AdvancingMind/Spyder-Crab/README.md

# Spyder-Crab
This is the spider crab design using Klann mechanism. We call it OCTBUT! :)

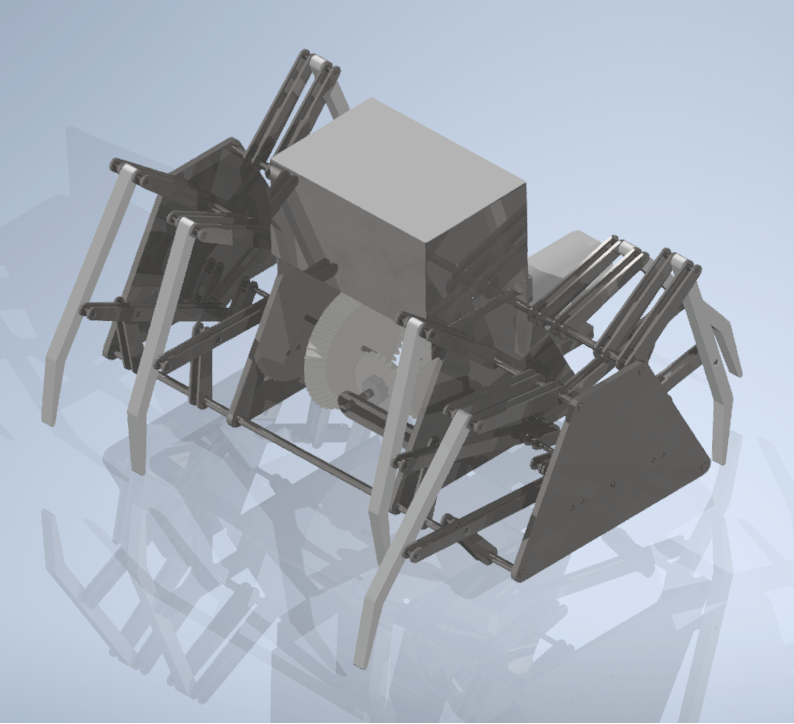
[picture p1: OCTBUG.png]

![]()
