AdvancingMind/Spyder-Crab/Drawings/Pdf/Untitled.png

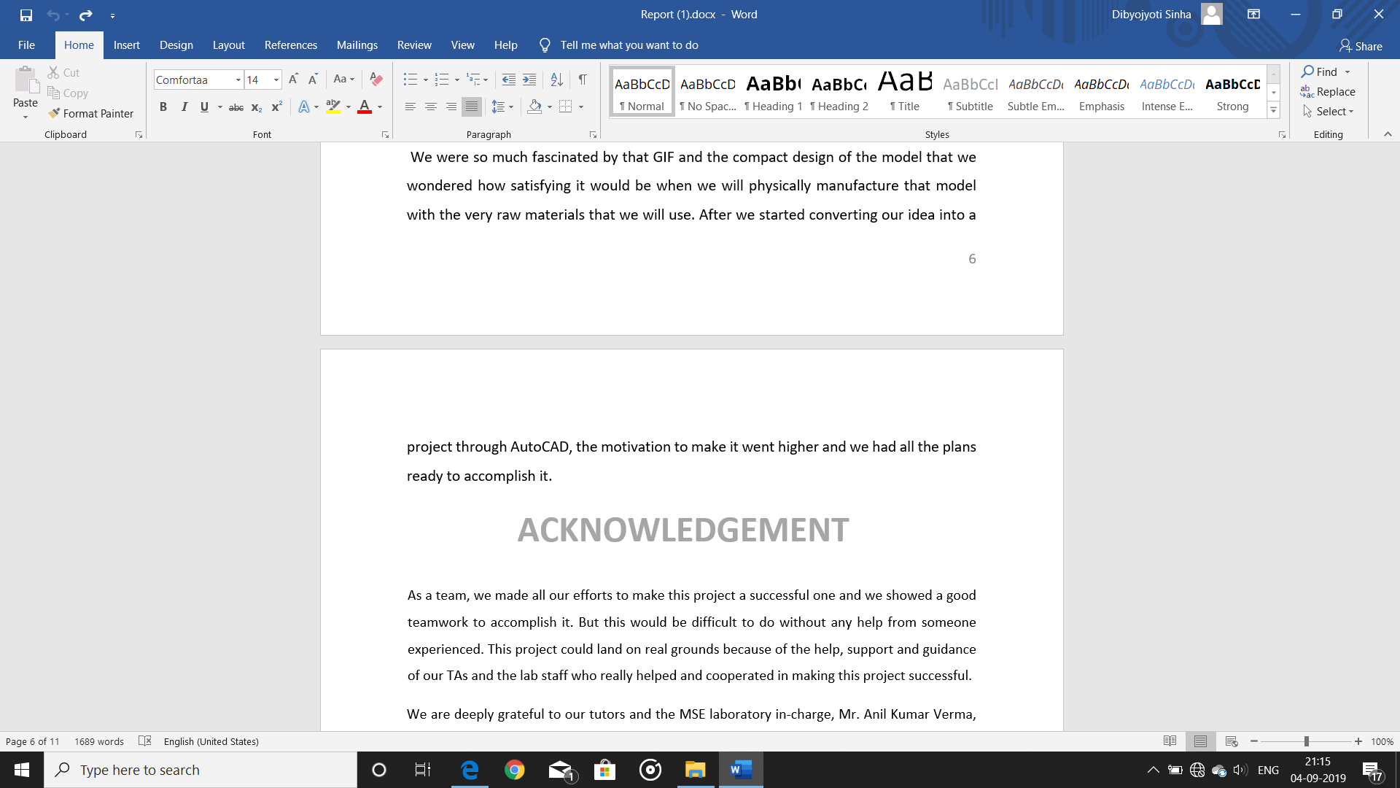
Drawings/Pdf/Untitled.png
