AdvancingMind/Spyder-Crab/sketch.dxf

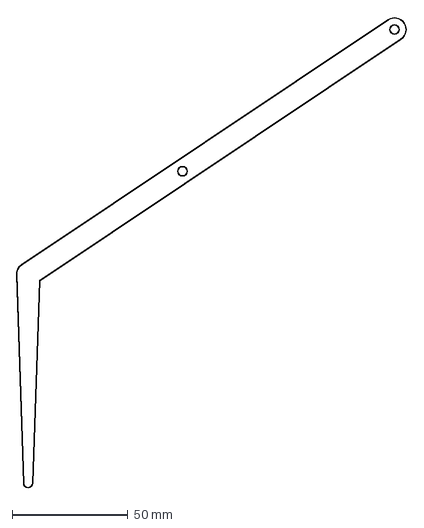
[picture p9: CAD file, 2020-01-12]
sketch.dxf
168.8 x 203.2 mm
