AdvancingMind/Spyder-Crab/(list of files, cad)

Other CAD files:
Drawings/Cabin Wall Assembly.dwg
Drawings/Main Assembly Spider Crab.dwg
Drawings/Leg Pair Assembly Spider Crab.dwg
Drawings/1-1 Templates/parts set 1.dwg
Drawings/Cabin Side Panel.dwg
Drawings/1-1 Templates/parts set 2.dwg
Drawings/Leg Spider Crab.dwg
Drawings/1-1 Templates/parts set 3.dwg
Drawings/Crank Joint Pin Spider Crab.dwg
Drawings/Upper Rocker Arm Spider Crab.dwg
Drawings/Cabin Frame.dwg
Drawings/Lower Rocker Arm Spider Crab.dwg
Drawings/Crank.dwg
Drawings/Rocker arm.dwg
Drawings/Frame.dwg
Drawings/Flywheel.dwg
Drawings/Cabin Hold.dwg
Drawings/Leg Joint Pins.dwg
Battery Box.ipt
Cabin Assembly.iam
Cabin Back Panel.ipt
Cabin Frame.ipt
Cabin Frame_MIR.ipt
Cabin Hold.ipt
Cabin Hold_MIR.ipt
Cabin Roof.ipt
Cabin Side Panel.ipt
Cabin Side Panel_MIR.ipt
Cabin Wall Assembly.iam
Cabin Wall Assembly_MIR.iam
Cabin front panel.ipt
Crank Joint Pin Spider Crab.ipt
Crank Joint Pin extended Spider Crab.ipt
Crank.ipt
Drawings/1-1 Templates/OldVersions/parts set 1.0002.dwg
Drawings/1-1 Templates/OldVersions/parts set 2.0004.dwg
Drawings/1-1 Templates/OldVersions/parts set 3.0002.dwg
Drawings/Dummy Parts/Crank Coupler Pin 40mm.ipt
Drawings/Dummy Parts/Crank Coupler Pin Extended 138 mm.ipt
Drawings/Dummy Parts/Flywheel with hole.ipt
Drawings/Dummy Parts/OldVersions/Crank Coupler Pin 40mm.0001.ipt
Drawings/Dummy Parts/OldVersions/Crank Coupler Pin Extended 138 mm.0001.ipt
Drawings/Dummy Parts/OldVersions/Flywheel with hole.0005.ipt
Drawings/OldVersions/Cabin Frame.0001.dwg
Drawings/OldVersions/Cabin Hold.0001.dwg
Drawings/OldVersions/Cabin Side Panel.0002.dwg
Drawings/OldVersions/Cabin Wall Assembly.0001.dwg
Drawings/OldVersions/Crank Joint Pin Spider Crab.0004.dwg
Drawings/OldVersions/Crank.0005.dwg
Drawings/OldVersions/Flywheel.0002.dwg
Drawings/OldVersions/Frame.0003.dwg
Drawings/OldVersions/Joint Pins.0003.dwg
Drawings/OldVersions/Leg Joint Pins.0005.dwg
Drawings/OldVersions/Leg Pair Assembly Spider Crab.0004.dwg
Drawings/OldVersions/Leg Spider Crab.0007.dwg
Drawings/OldVersions/Lower Rocker Arm Spider Crab.0008.dwg
Drawings/OldVersions/Main Assembly Spider Crab.0007.dwg
Drawings/OldVersions/Rocker arm.0006.dwg
Drawings/OldVersions/Upper Rocker Arm Spider Crab.0003.dwg
Flywheel.ipt
Frame.ipt
Joint Pin Spider Crab.ipt
Leg Pair Assembly Spider Crab.iam
Leg Spider Crab.ipt
Long Joint Pin Spider Crab.ipt
Lower Rocker Arm Spider Crab.ipt
Main Assembly Spider Crab.iam
OldVersions/6x6mm square rod.0001.ipt
OldVersions/Assembly Spider Crab.0006.iam
OldVersions/Battery Box.0006.ipt
OldVersions/Cabin Assembly.0029.iam
OldVersions/Cabin Back Panel.0002.ipt
OldVersions/Cabin Frame.0005.ipt
OldVersions/Cabin Frame_MIR.0002.ipt
OldVersions/Cabin Hold.0006.ipt
OldVersions/Cabin Hold_MIR.0001.ipt
OldVersions/Cabin Roof.0002.ipt
OldVersions/Cabin Side Panel.0006.ipt
OldVersions/Cabin Side Panel_MIR.0002.ipt
OldVersions/Cabin Side.0012.ipt
OldVersions/Cabin Wall Assembly.0009.iam
OldVersions/Cabin Wall Assembly_MIR.0002.iam
OldVersions/Cabin Wall.0015.ipt
OldVersions/Cabin Wall_MIR2.0002.ipt
OldVersions/Cabin front panel.0003.ipt
OldVersions/Cabin.0004.ipt
OldVersions/Crank Joint Pin Spider Crab.0003.ipt
OldVersions/Crank Joint Pin Spider Crab.0004.ipt
OldVersions/Crank Joint Pin Spider Crab.0005.ipt
OldVersions/Crank Joint Pin Spider Crab.0006.ipt
OldVersions/Crank Joint Pin extended Spider Crab.0004.ipt
OldVersions/Crank Joint Pin extended Spider Crab.0005.ipt
OldVersions/Crank.0007.ipt
OldVersions/Flywheel.0005.ipt
OldVersions/Frame.0003.ipt
OldVersions/Joint Pin Spider Crab.0002.ipt
OldVersions/Joint Pin Spider Crab.0003.ipt
OldVersions/Joint Pin Spider Crab.0004.ipt
OldVersions/Joint Pin Spider Crab.0005.ipt
OldVersions/Leg Pair Assembly Spider Crab.0035.iam
OldVersions/Leg Spider Crab.0006.ipt
OldVersions/Leg Spider Crab.0007.ipt
OldVersions/Long Joint Pin Spider Crab.0001.ipt
OldVersions/Lower Rocker Arm Spider Crab.0009.ipt
OldVersions/Lower Rocker Arm Spider Crab.0010.ipt
OldVersions/Main Assembly Spider Crab.0065.iam
OldVersions/Rocker arm Leg Spider Crab.0006.ipt
OldVersions/Rocker arm Leg Spider Crab.0007.ipt
OldVersions/Rocker arm Leg Spider Crab.0008.ipt
OldVersions/Short Joint Pin Spider Crab.0001.ipt
OldVersions/Short Joint Pin Spider Crab.0002.ipt
OldVersions/Upper Rocker Arm Spider Crab.0006.ipt
OldVersions/Upper Rocker Arm Spider Crab.0007.ipt
OldVersions/Upper Rocker Arm Spider Crab.0008.ipt
OldVersions/Upper Rocker Arm Spider Crab.0010.ipt
OldVersions/Upper Rocker Arm Spider Crab.0012.ipt
OldVersions/Upper Rod Spider Crab.0001.ipt
OldVersions/Upper Rod Spider Crab.0002.ipt
OldVersions/Upper Rod Spider Crab.0003.ipt
OldVersions/Upper Rod Spider Crab.0004.ipt
OldVersions/Upper Rod Spider Crab.0005.ipt
OldVersions/Upper Rod extended Spider Crab.0004.ipt
OldVersions/Upper Rod extended Spider Crab.0005.ipt
Part1.ipt
Rocker arm Leg Spider Crab.ipt
Short Joint Pin Spider Crab.ipt
Upper Rocker Arm Spider Crab.ipt
Upper Rod Spider Crab.ipt
Upper Rod extended Spider Crab.ipt
test Main Assembly Spider Crab.ipn
