AdvancingMind/Spyder-Crab/Drawings/Pdf/Main Assembly Spider Crab.bmp

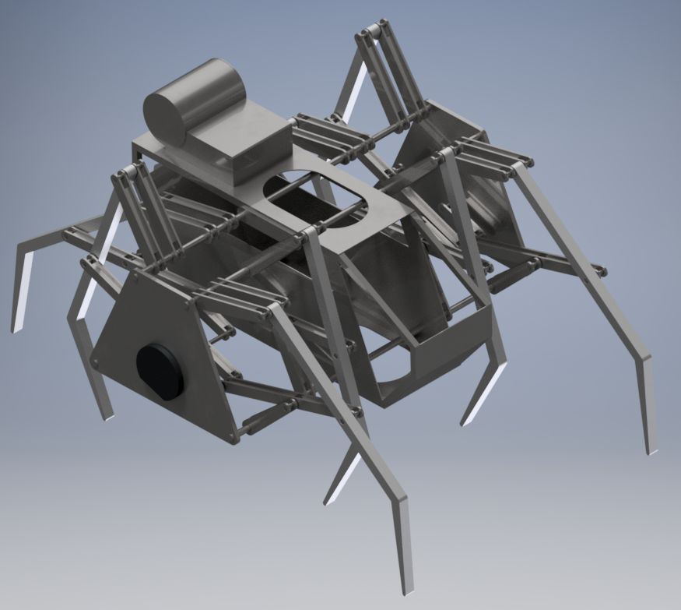
Drawings/Pdf/Main Assembly Spider Crab.bmp
