AdvancingMind/Spyder-Crab/Main Assembly Spider Crab.bmp

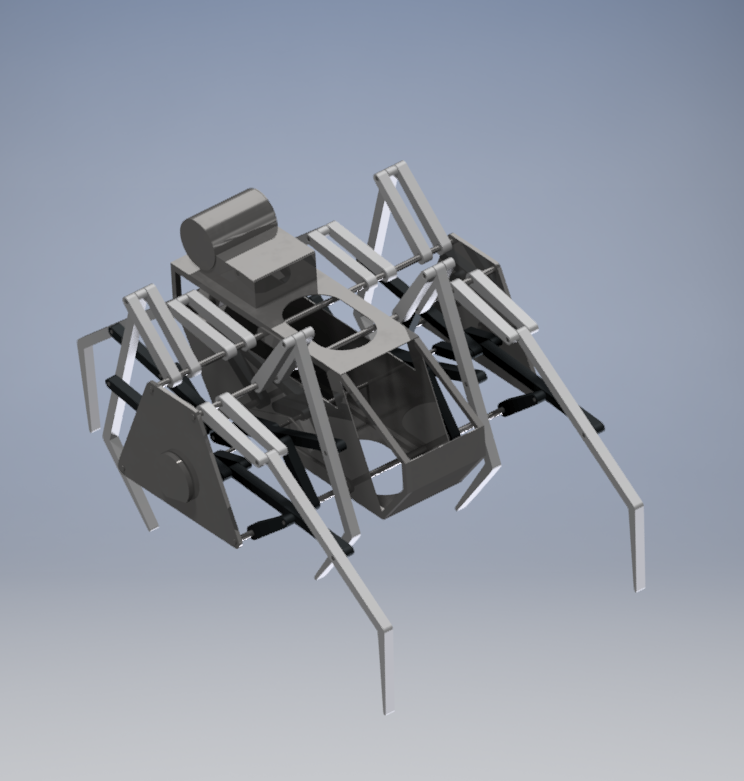
Main Assembly Spider Crab.bmp
