AdvancingMind/Spyder-Crab/Drawings/1-1 Templates/pdf/parts set 1.pdf

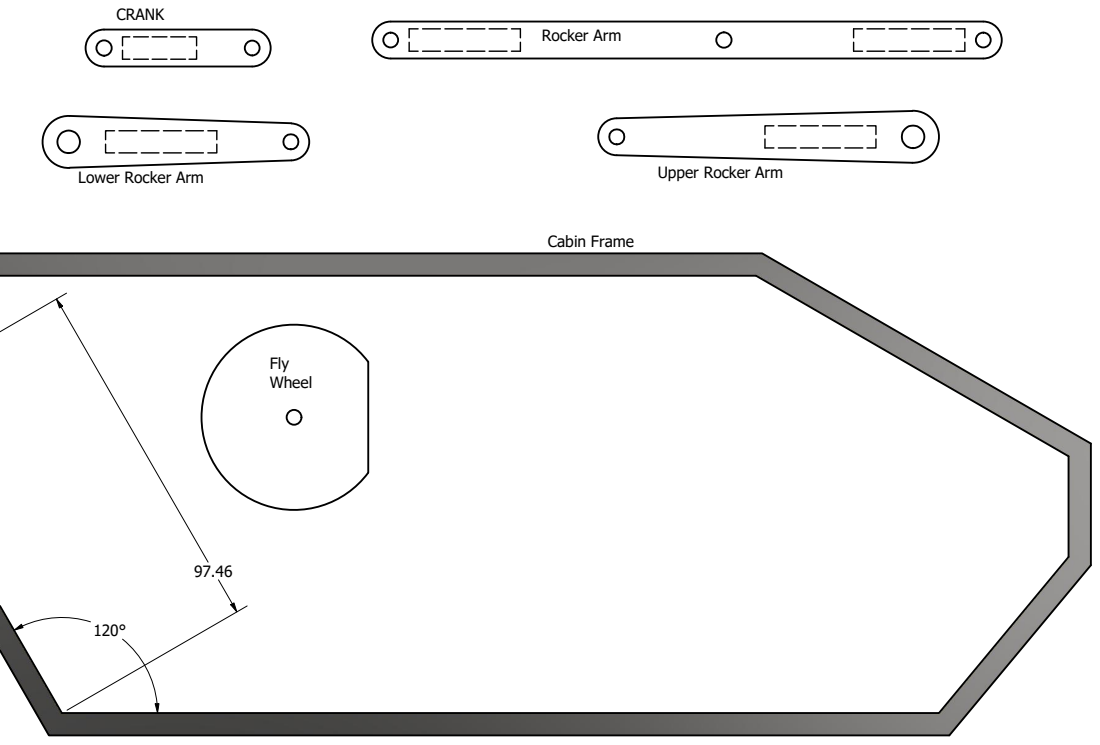
[picture p12: page 1]
Cabin Frame; Rocker Arm; Lower Rocker Arm; Upper Rocker Arm
