AdvancingMind/Spyder-Crab/Drawings/1-1 Templates/pdf/parts set 2.pdf

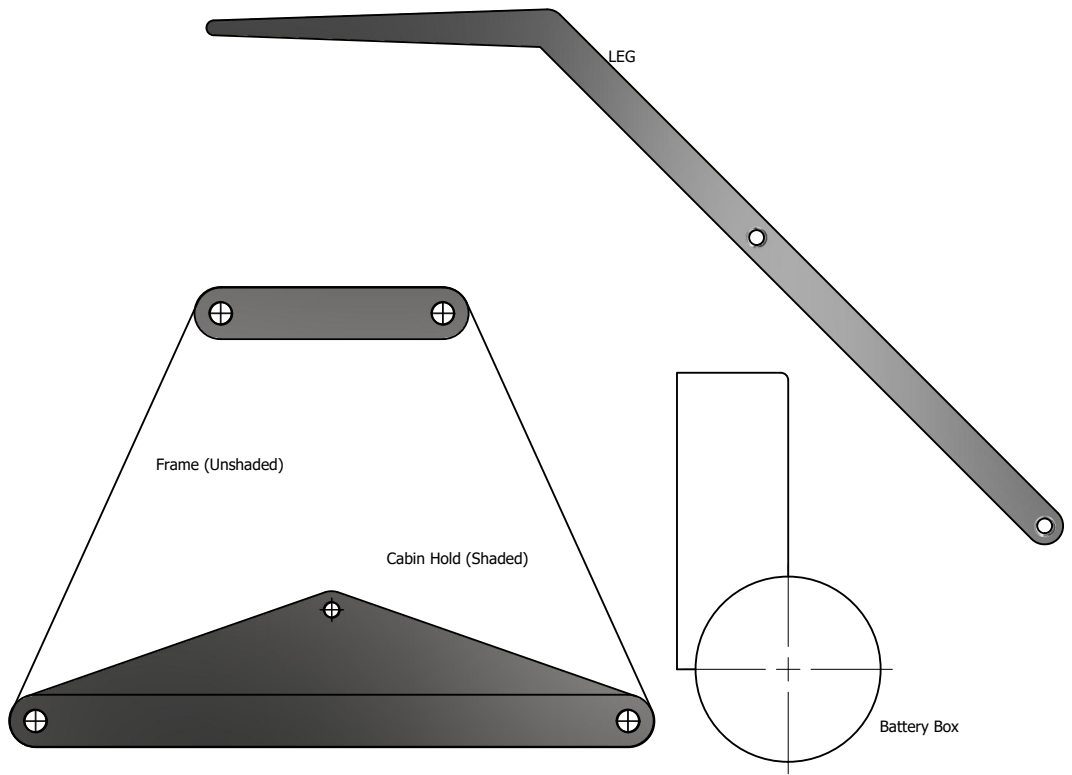
[picture p13: page 1]
Frame (Unshaded); Battery Box

Cabin Hold (Shaded)
