AdvancingMind/Spyder-Crab/Drawings/1-1 Templates/pdf/parts set 3.pdf

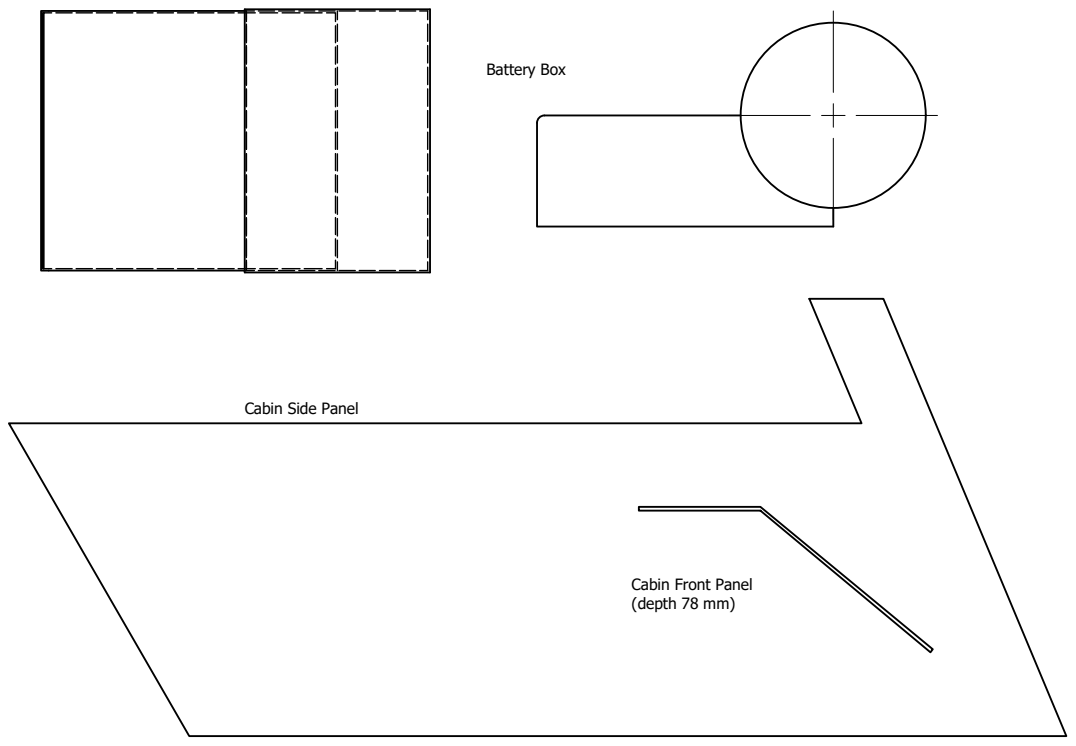
[picture p14: page 1]
Battery Box

Cabin Side Panel

Cabin Front Panel
(depth 78 mm)
