AdvancingMind/Spyder-Crab/Drawings/Pdf/Autocad Pdf/Cabin Assembly.pdf

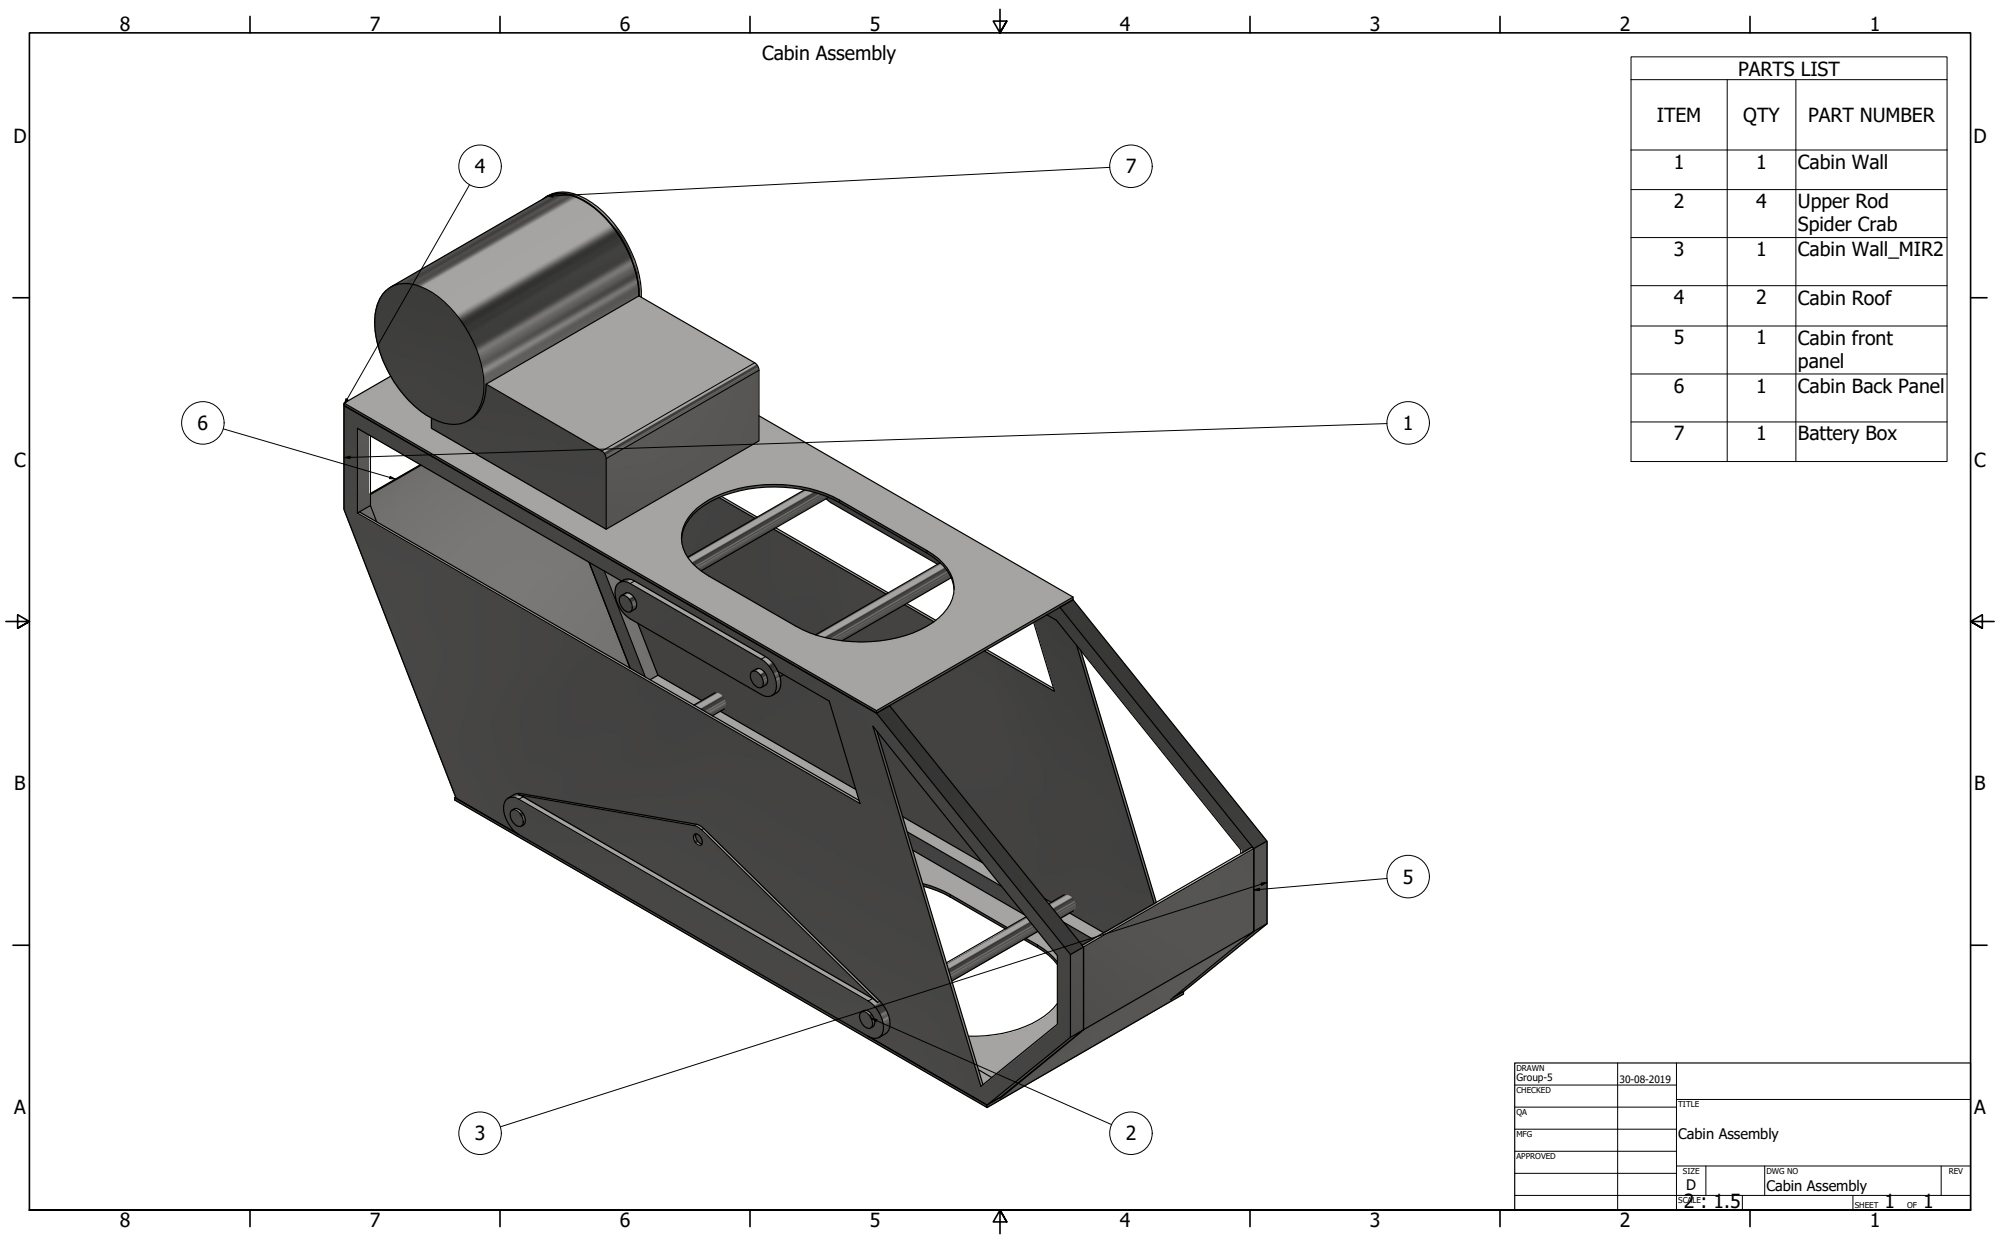
[picture p15: page 1]
Battery Box 11

1 | 1 | C a b i n W all Upper Rod Spider Cra

3 | 1 | C a b i n W all_ M I R 2

1 6 1 | C Cabin a b el 5 i n f r o n t p a n

S I Z E D | D W G N O C a b i n A s s e m bly | R E V
