AdvancingMind/Spyder-Crab/Drawings/Pdf/Autocad Pdf/Cabin Wall Assembly.pdf

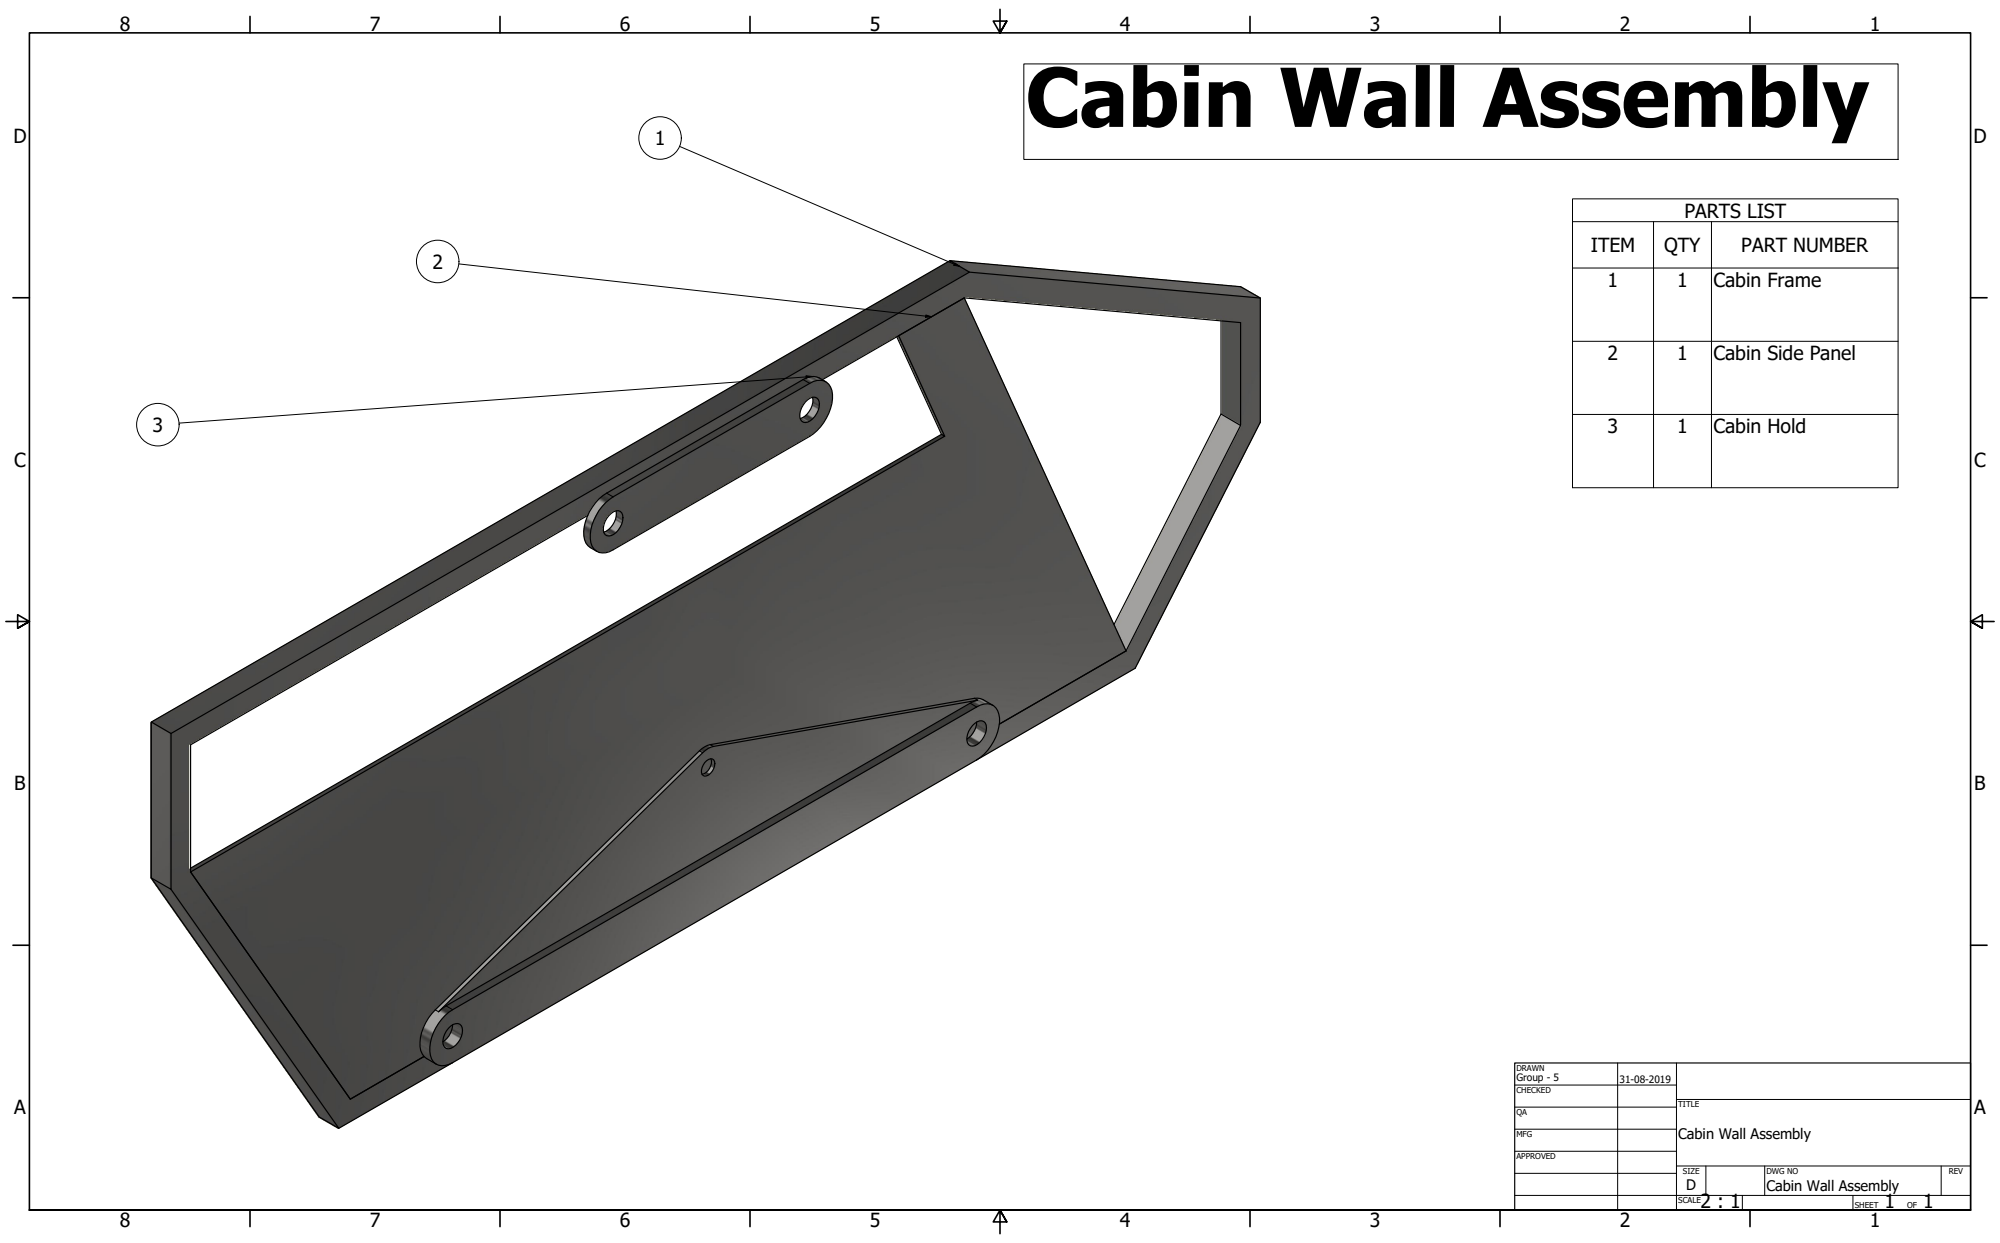
[picture p16: page 1]
PARTS LIST

Cabin Wall Assembly

ITEM | QTY | PART NUMBER
1 | 1 | Cabin Frame

2 | 1 | Cabin Side Panel

3 | 1 | Cabin Hold

DRAWN Group - 5 | 31-08-2019

CHECKED

MFG

APPROVED

SIZE D | DWG NO Cabin Wall Assembly | REV

2 : 1 SCALE | | SHEET 1 OF 1
