AdvancingMind/Spyder-Crab/Drawings/Pdf/Autocad Pdf/Main Assembly Spider Crab.pdf

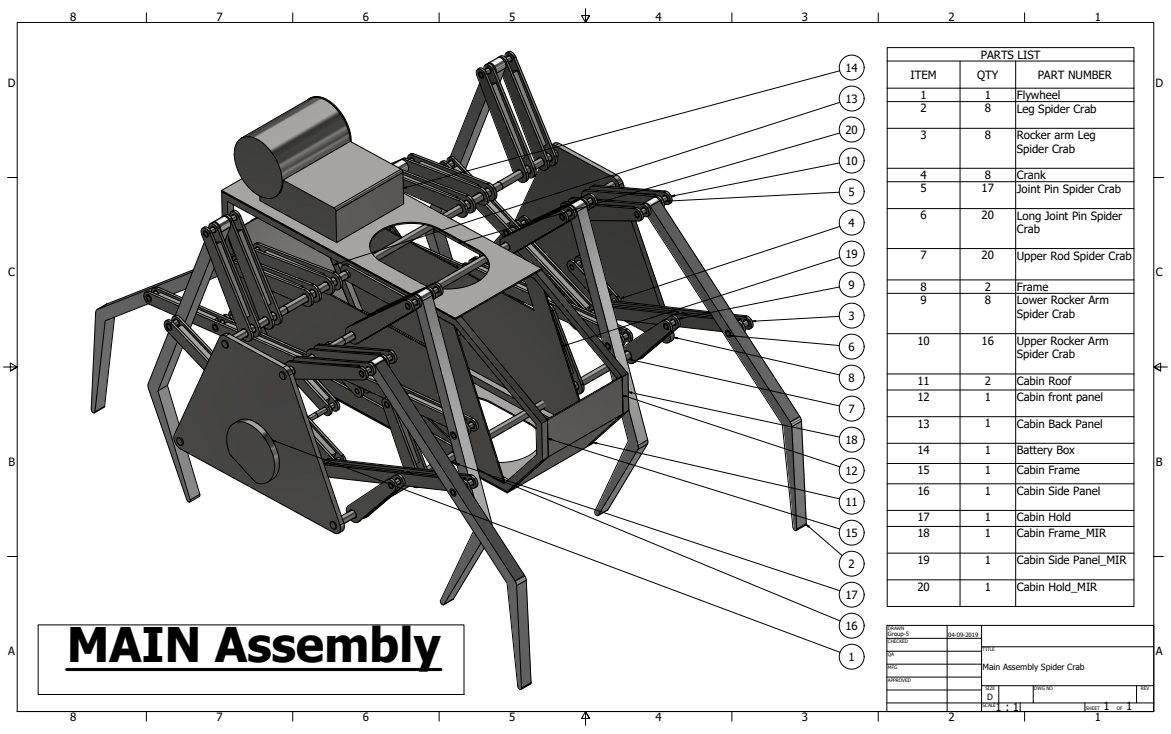
[picture p17: page 1]
Cabin Back Panel 14; Battery Box 15; Cabin Frame 16; Cabin Side Panel 17; Cabin Hold 18; Cabin Frame_MIR 19; Cabin Side Panel_

I T E M | Q TY | P A RT N U M B E R
1 | 1 8 | Fly Leg Spid w h e el 2

4 | 8 | C r a n k
5 | 1 7 | J o i n t P i n S p i d e r C r a b

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

1 1 | 2 | C a b i n R o o f
1 2 | 1 | C a b i n f r o n t p a n

2 0 | 1 | C a b i n H old _ M I
