AdvancingMind/Spyder-Crab/Drawings/Pdf/Autocad Pdf/Battery box.pdf

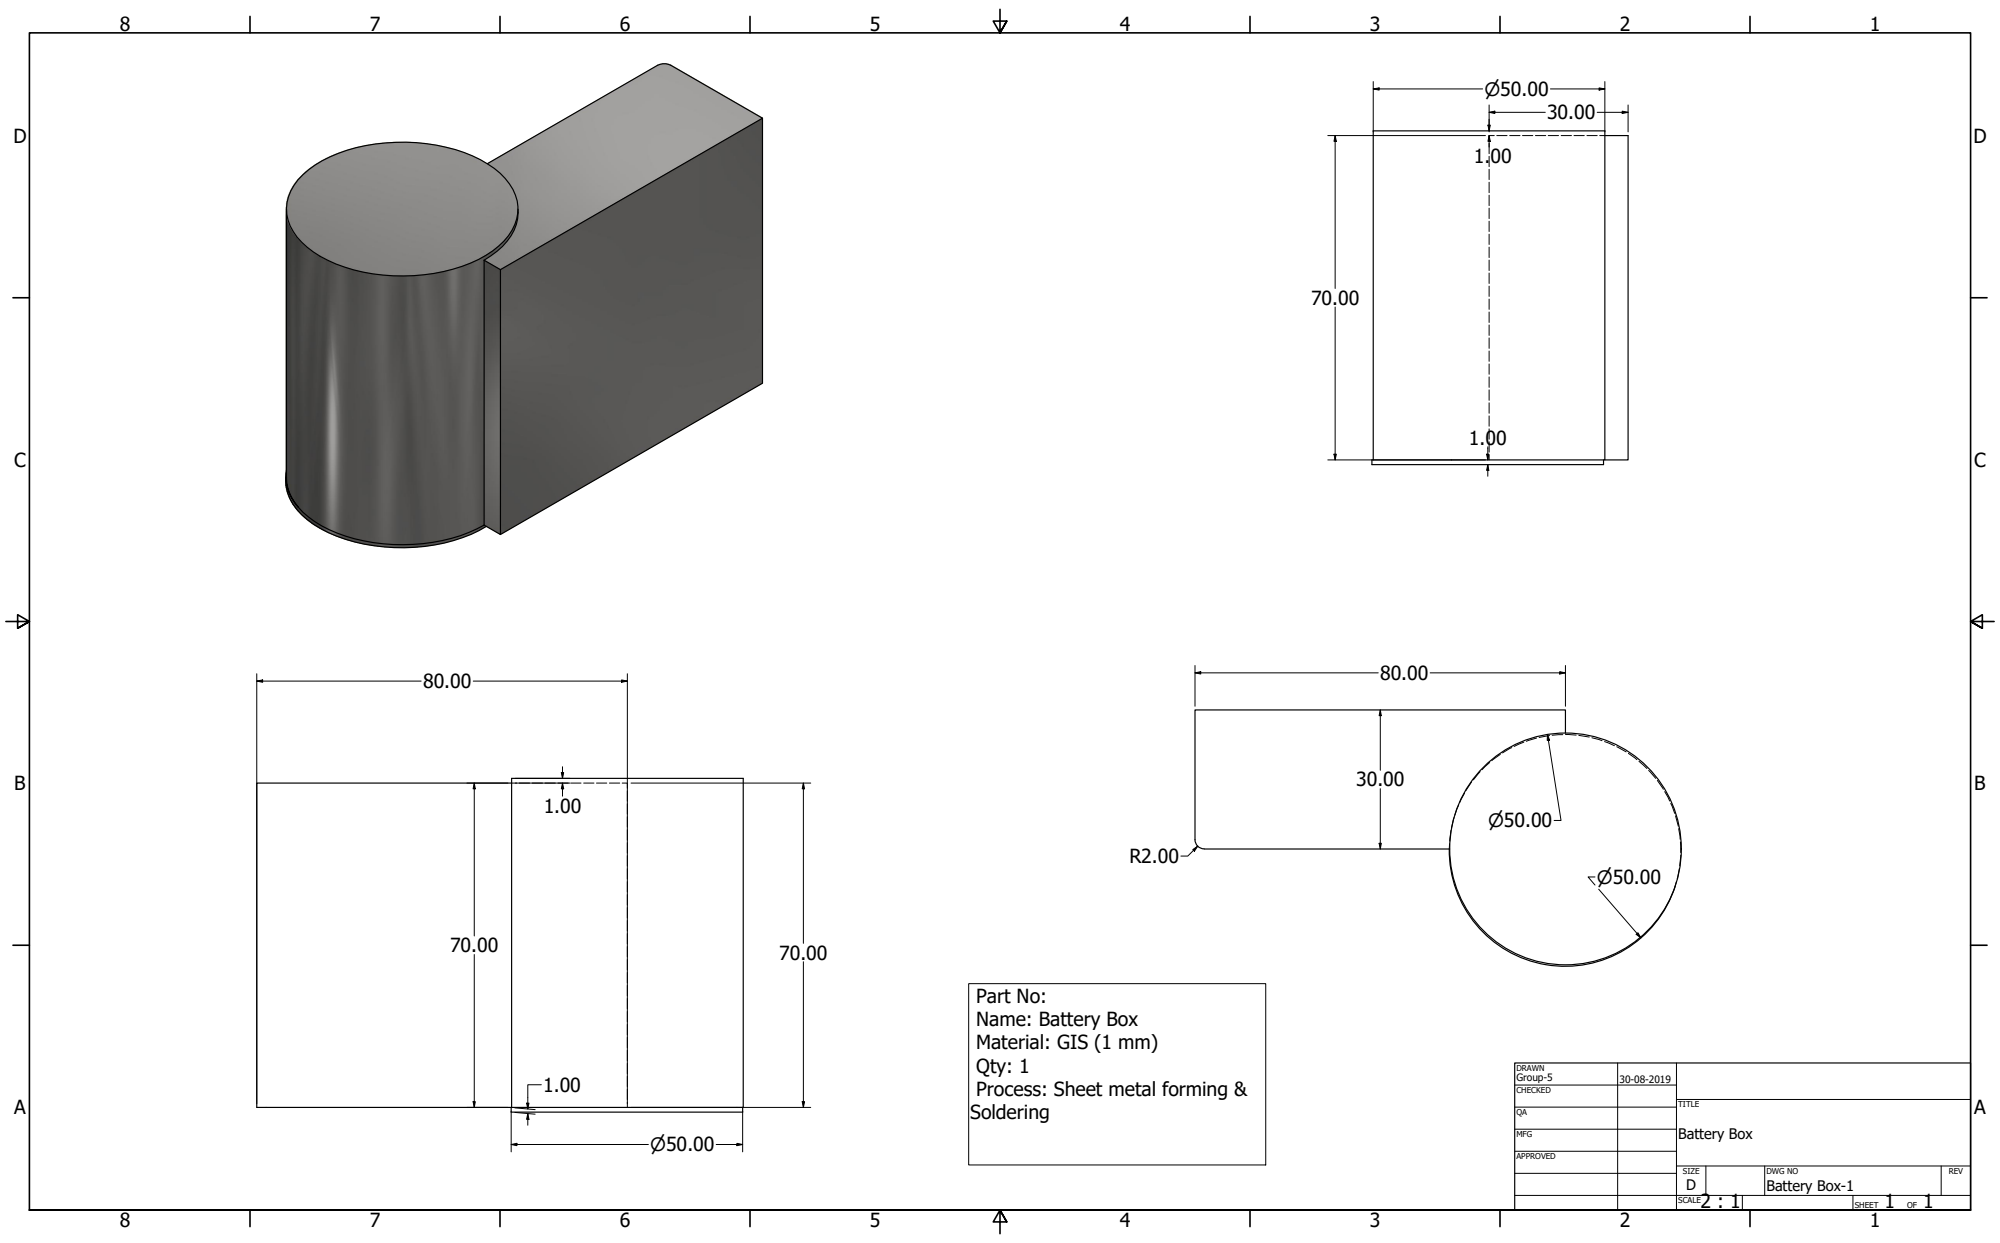
[picture p18: page 1]
Battery Box

Part No:
Name: Battery Box
Material: GIS (1 mm)
Qty: 1
Process: Sheet metal forming &
Soldering

DRAWN Group-5 | 30-08-2019

CHECKED

MFG

APPROVED

SIZE D | DWG NO Battery Box-1 | REV

2 : 1 SCALE | | SHEET 1 OF 1
