AdvancingMind/Spyder-Crab/Drawings/Pdf/Autocad Pdf/Cabin Back Panel.pdf

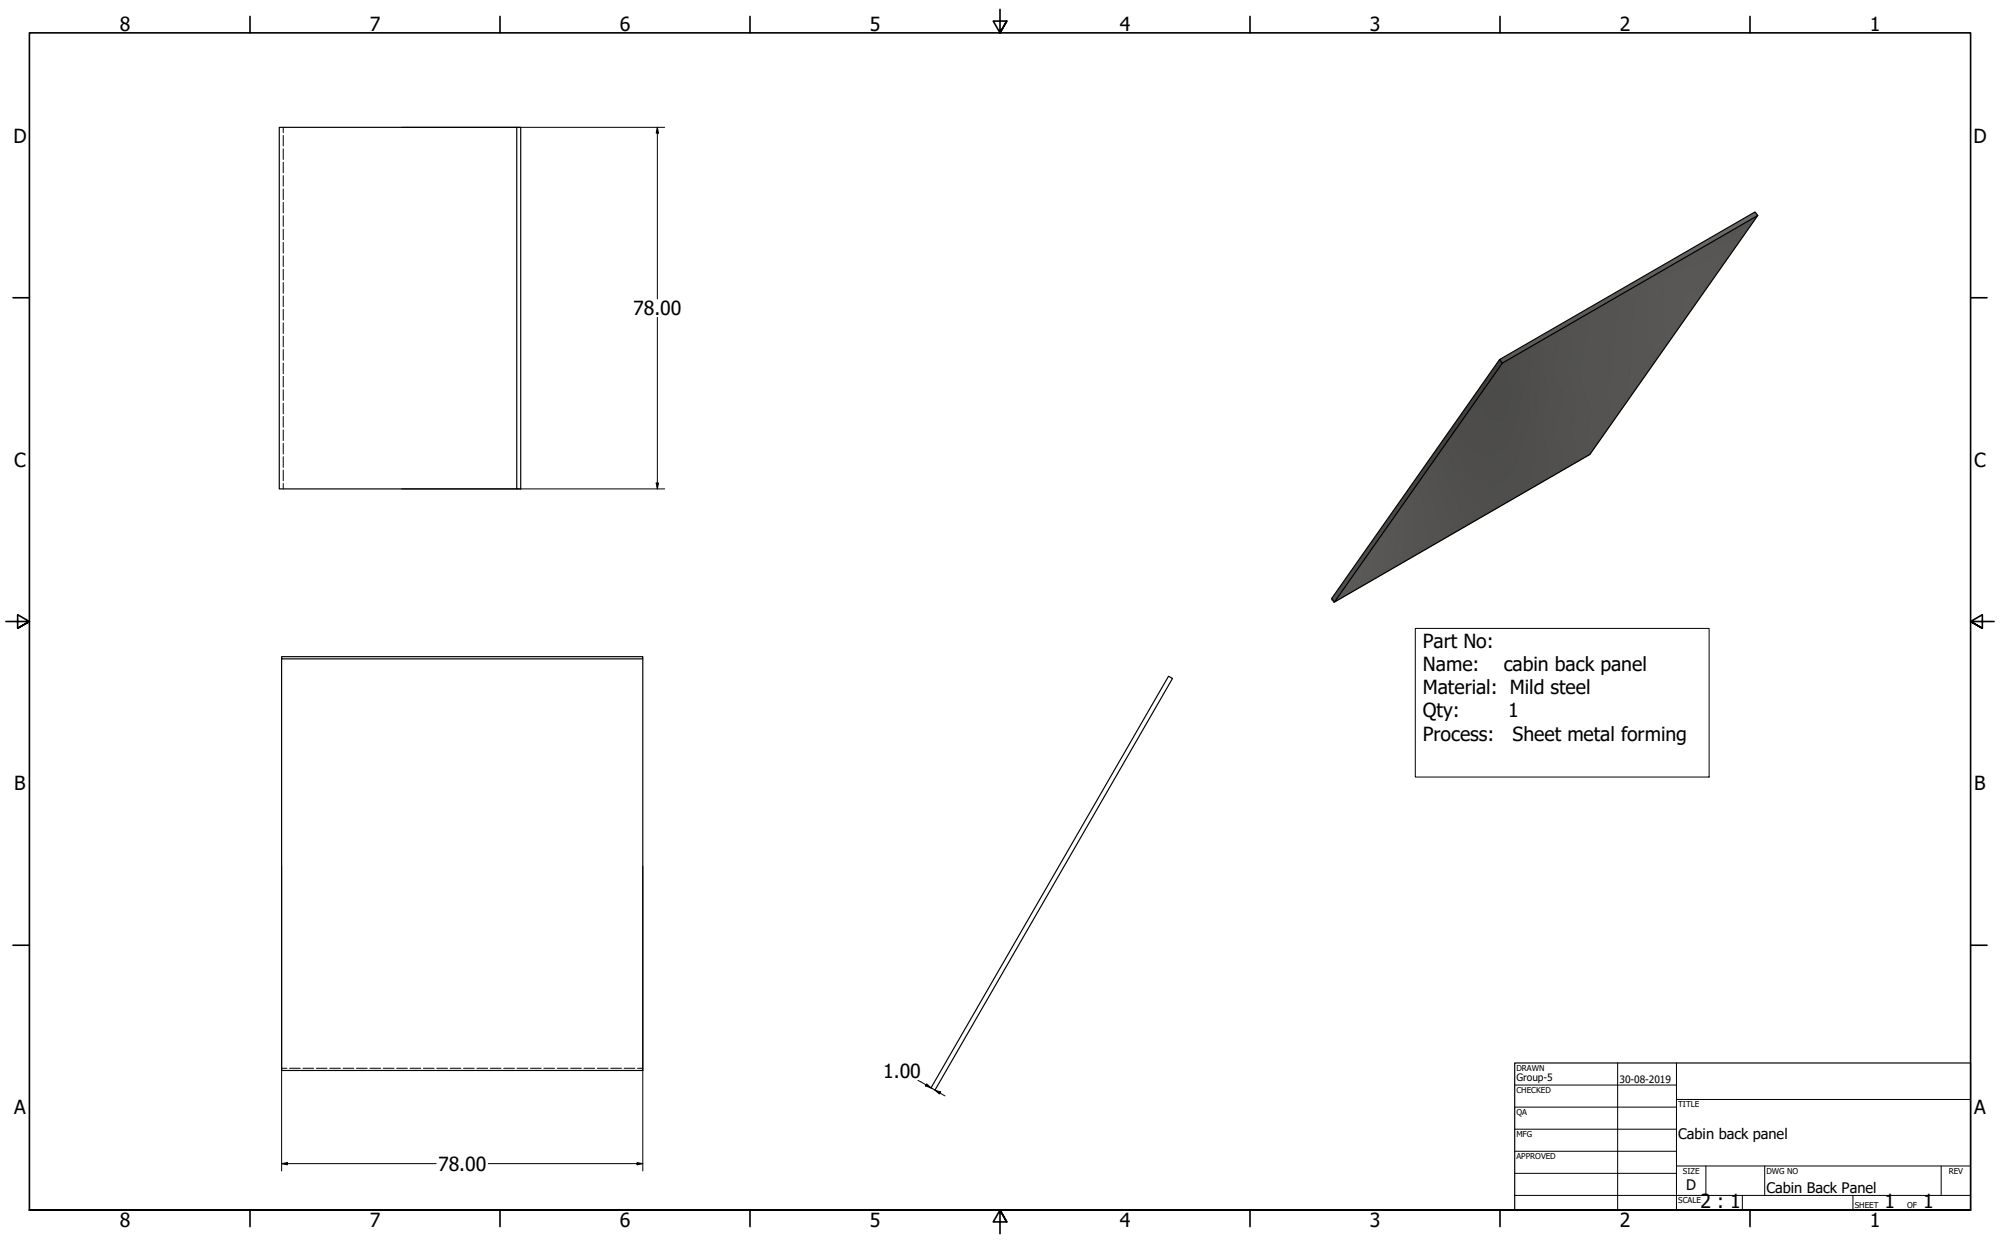
[picture p19: page 1]
Name:; cabin back panel

Part No:
Material: Mild steel
Process: Sheet metal forming

DRAWN Group-5 | 30-08-2019

CHECKED

Cabin back panel

MFG

APPROVED

SIZE D | DWG NO Cabin Back Panel | REV

2 : 1 SCALE | | SHEET 1 OF 1
