AdvancingMind/Spyder-Crab/Drawings/Pdf/Autocad Pdf/Cabin Frame.pdf

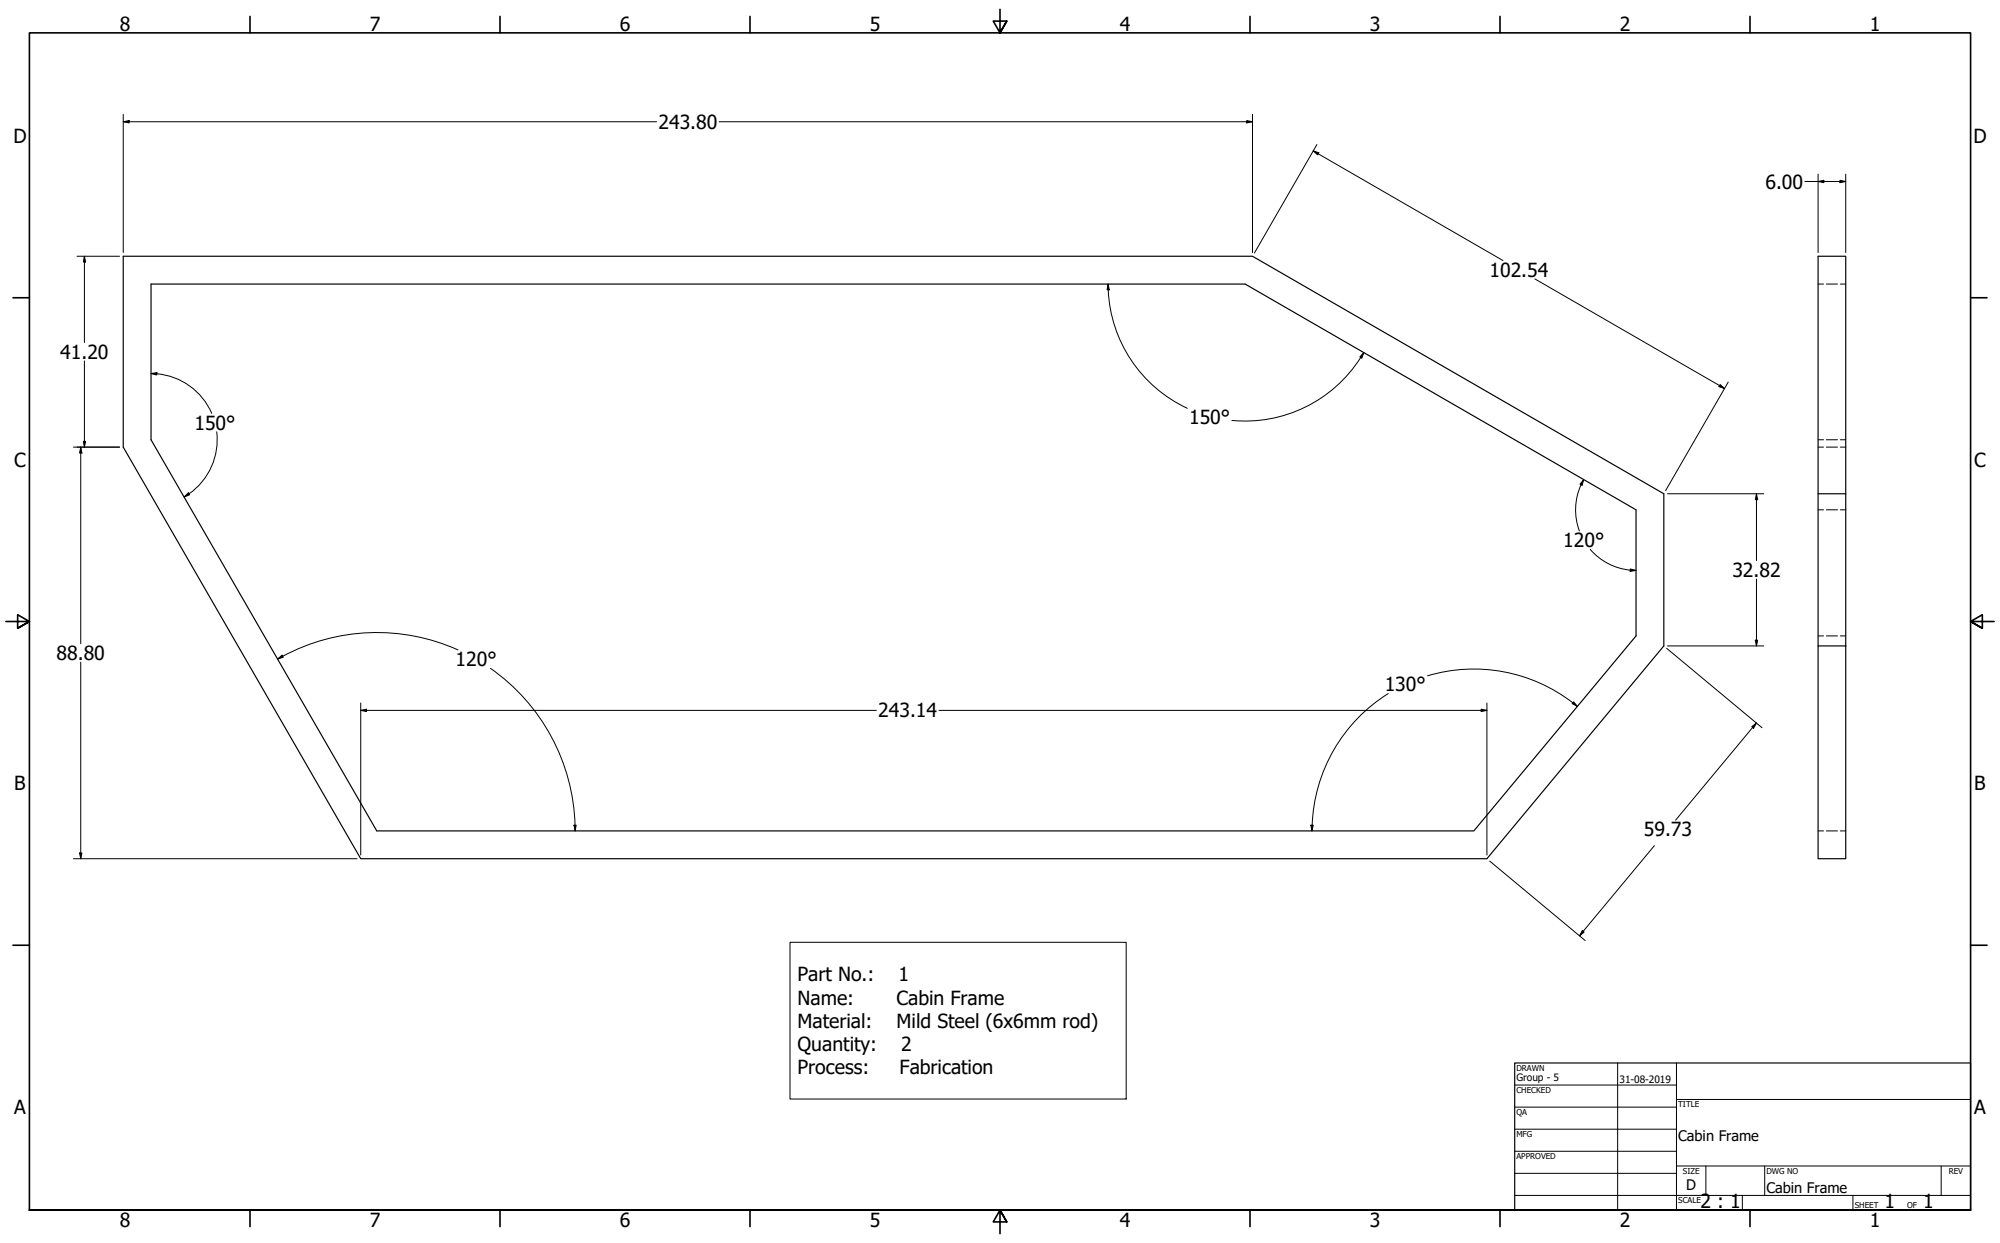
[picture p20: page 1]
Cabin Frame; Part No.:; Name:; Material:; Mild Steel (6x6mm rod)

DRAWN Group - 5 | 31-08-2019

CHECKED

MFG

APPROVED

SIZE D | DWG NO Cabin Frame | REV

2 : 1 SCALE | | SHEET 1 OF 1
