AdvancingMind/Spyder-Crab/Drawings/Pdf/Autocad Pdf/Cabin front panel.pdf

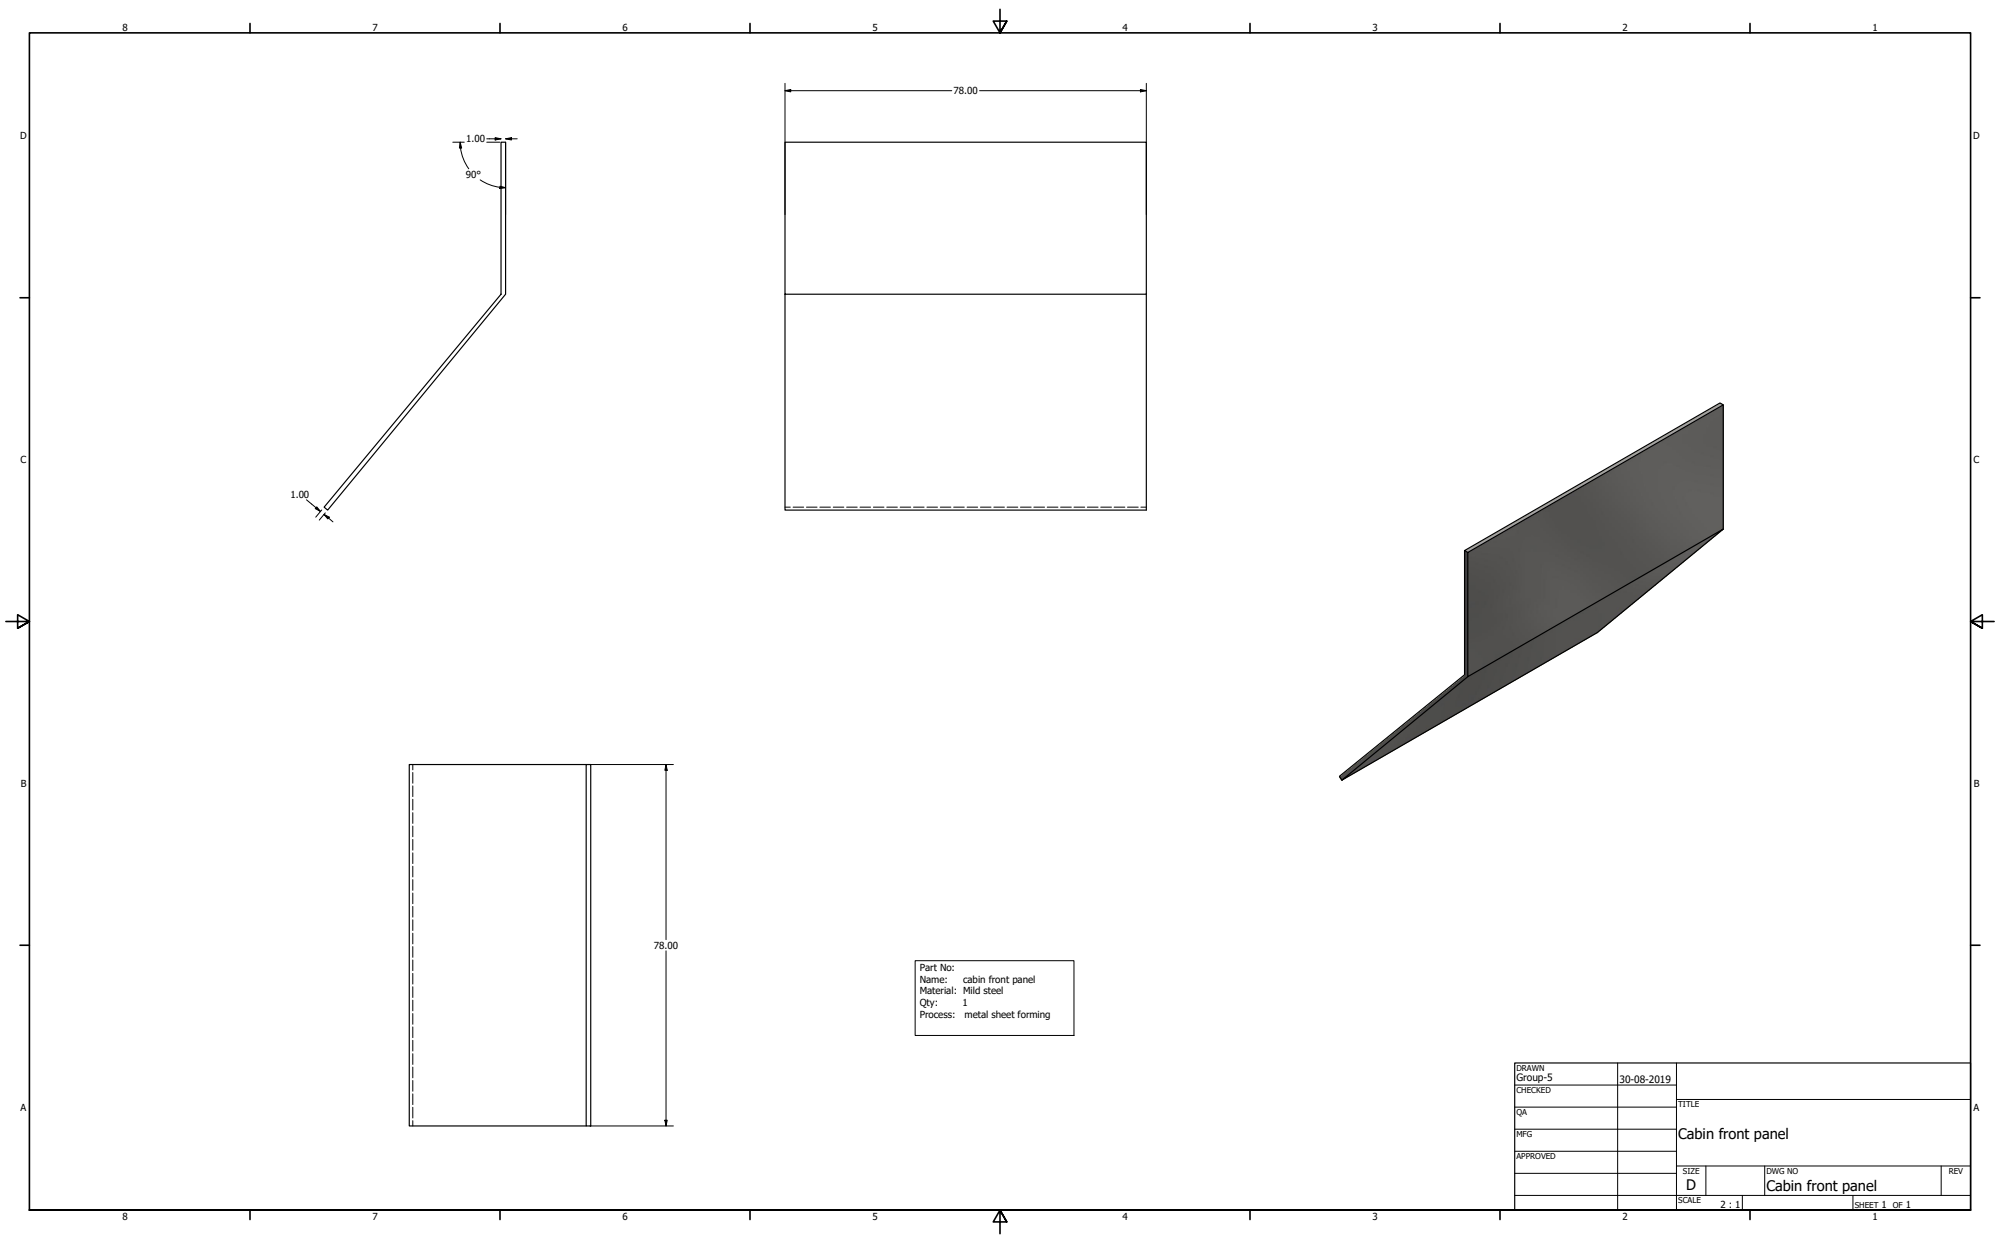
[picture p21: page 1]
Name:; cabin front panel

Part No:
Material: Mild steel
Process: metal sheet forming

DRAWN Group-5 | 30-08-2019

CHECKED

Cabin front panel

MFG

APPROVED

SIZE D | DWG NO Cabin front panel | REV

SCALE 2 : 1 | | SHEET 1 OF 1
