AdvancingMind/Spyder-Crab/Drawings/Pdf/Autocad Pdf/Cabin Hold.pdf

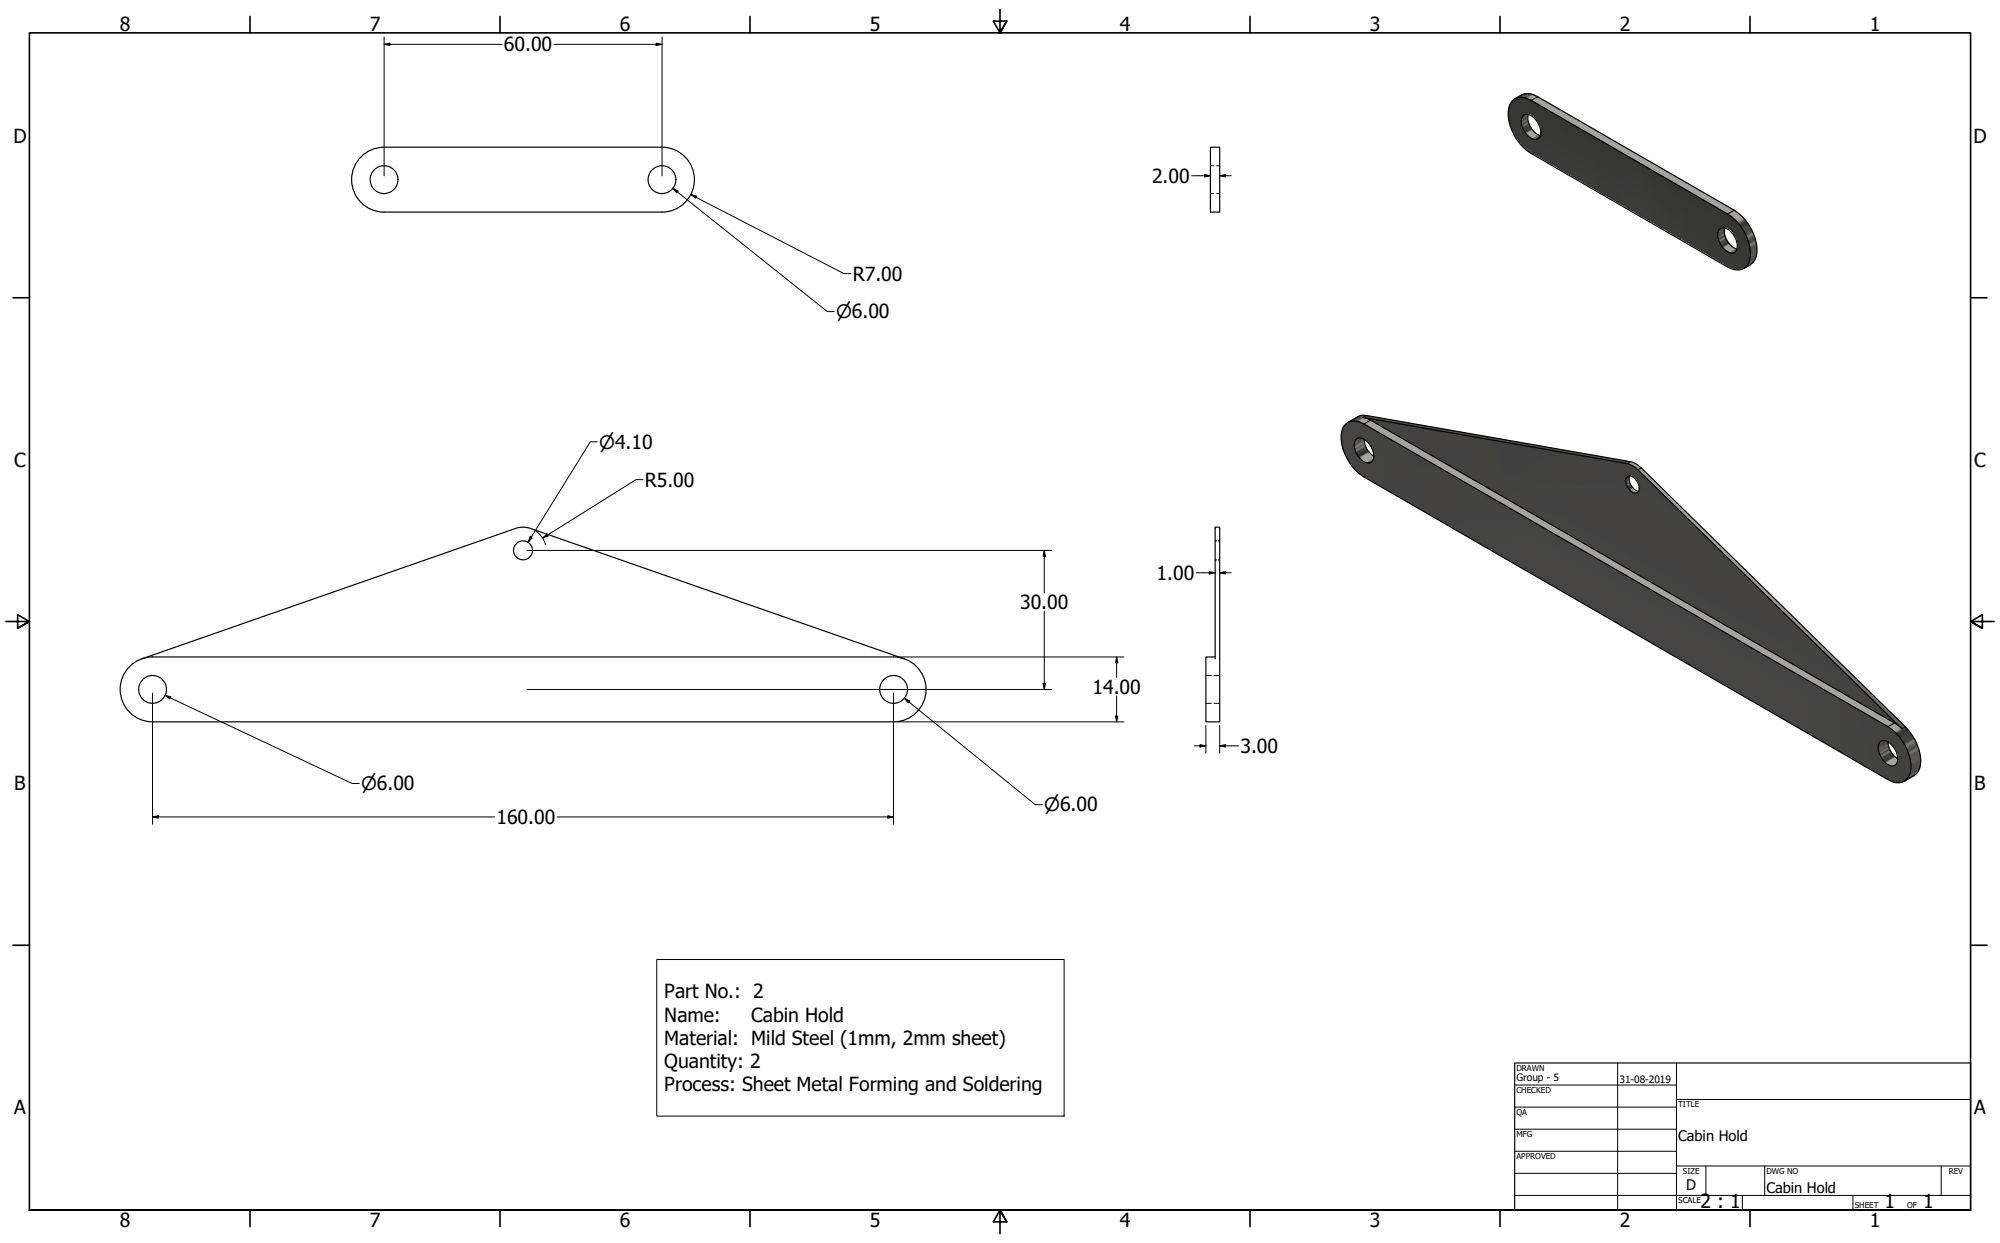
[picture p22: page 1]
Cabin Hold; Name:

Part No.: 2
Material: Mild Steel (1mm, 2mm sheet)
Quantity: 2
Process: Sheet Metal Forming and Soldering

DRAWN Group - 5 | 31-08-2019

CHECKED

MFG

APPROVED

SIZE D | DWG NO Cabin Hold | REV

2 : 1 SCALE | | SHEET 1 OF 1
