AdvancingMind/Spyder-Crab/Drawings/Pdf/Autocad Pdf/Cabin Roof.pdf

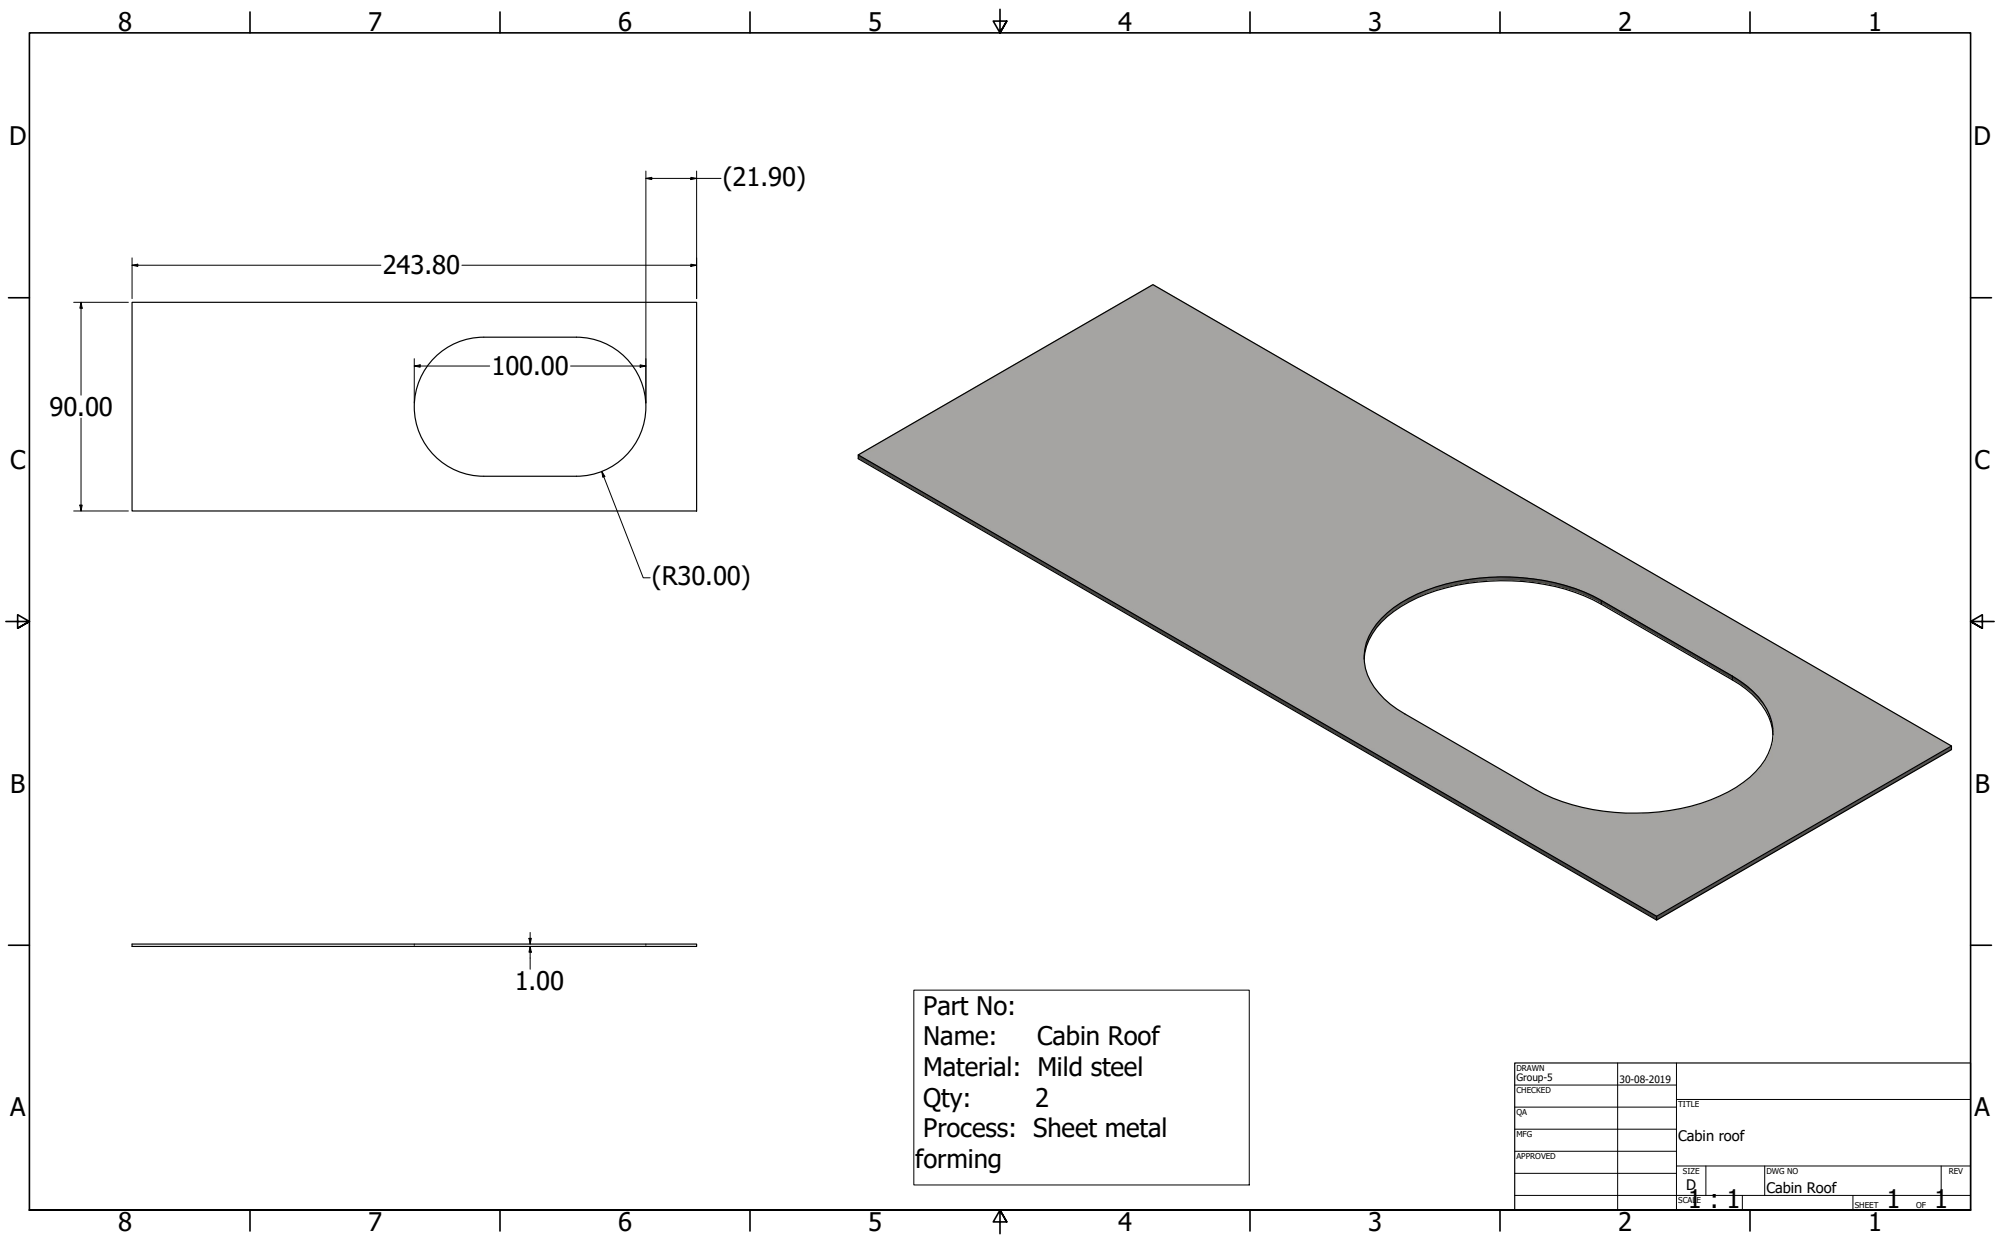
[picture p23: page 1]
Cabin roof; Name:; Cabin Roof

Part No:
Material: Mild steel
Process: Sheet metal
forming

DRAWN Group-5 | 30-08-2019

CHECKED

MFG

APPROVED

SIZE D | DWG NO Cabin Roof | REV

1 : 1 SCALE | | SHEET 1 OF 1
