AdvancingMind/Spyder-Crab/Drawings/Pdf/Autocad Pdf/Cabin Side Panel.pdf

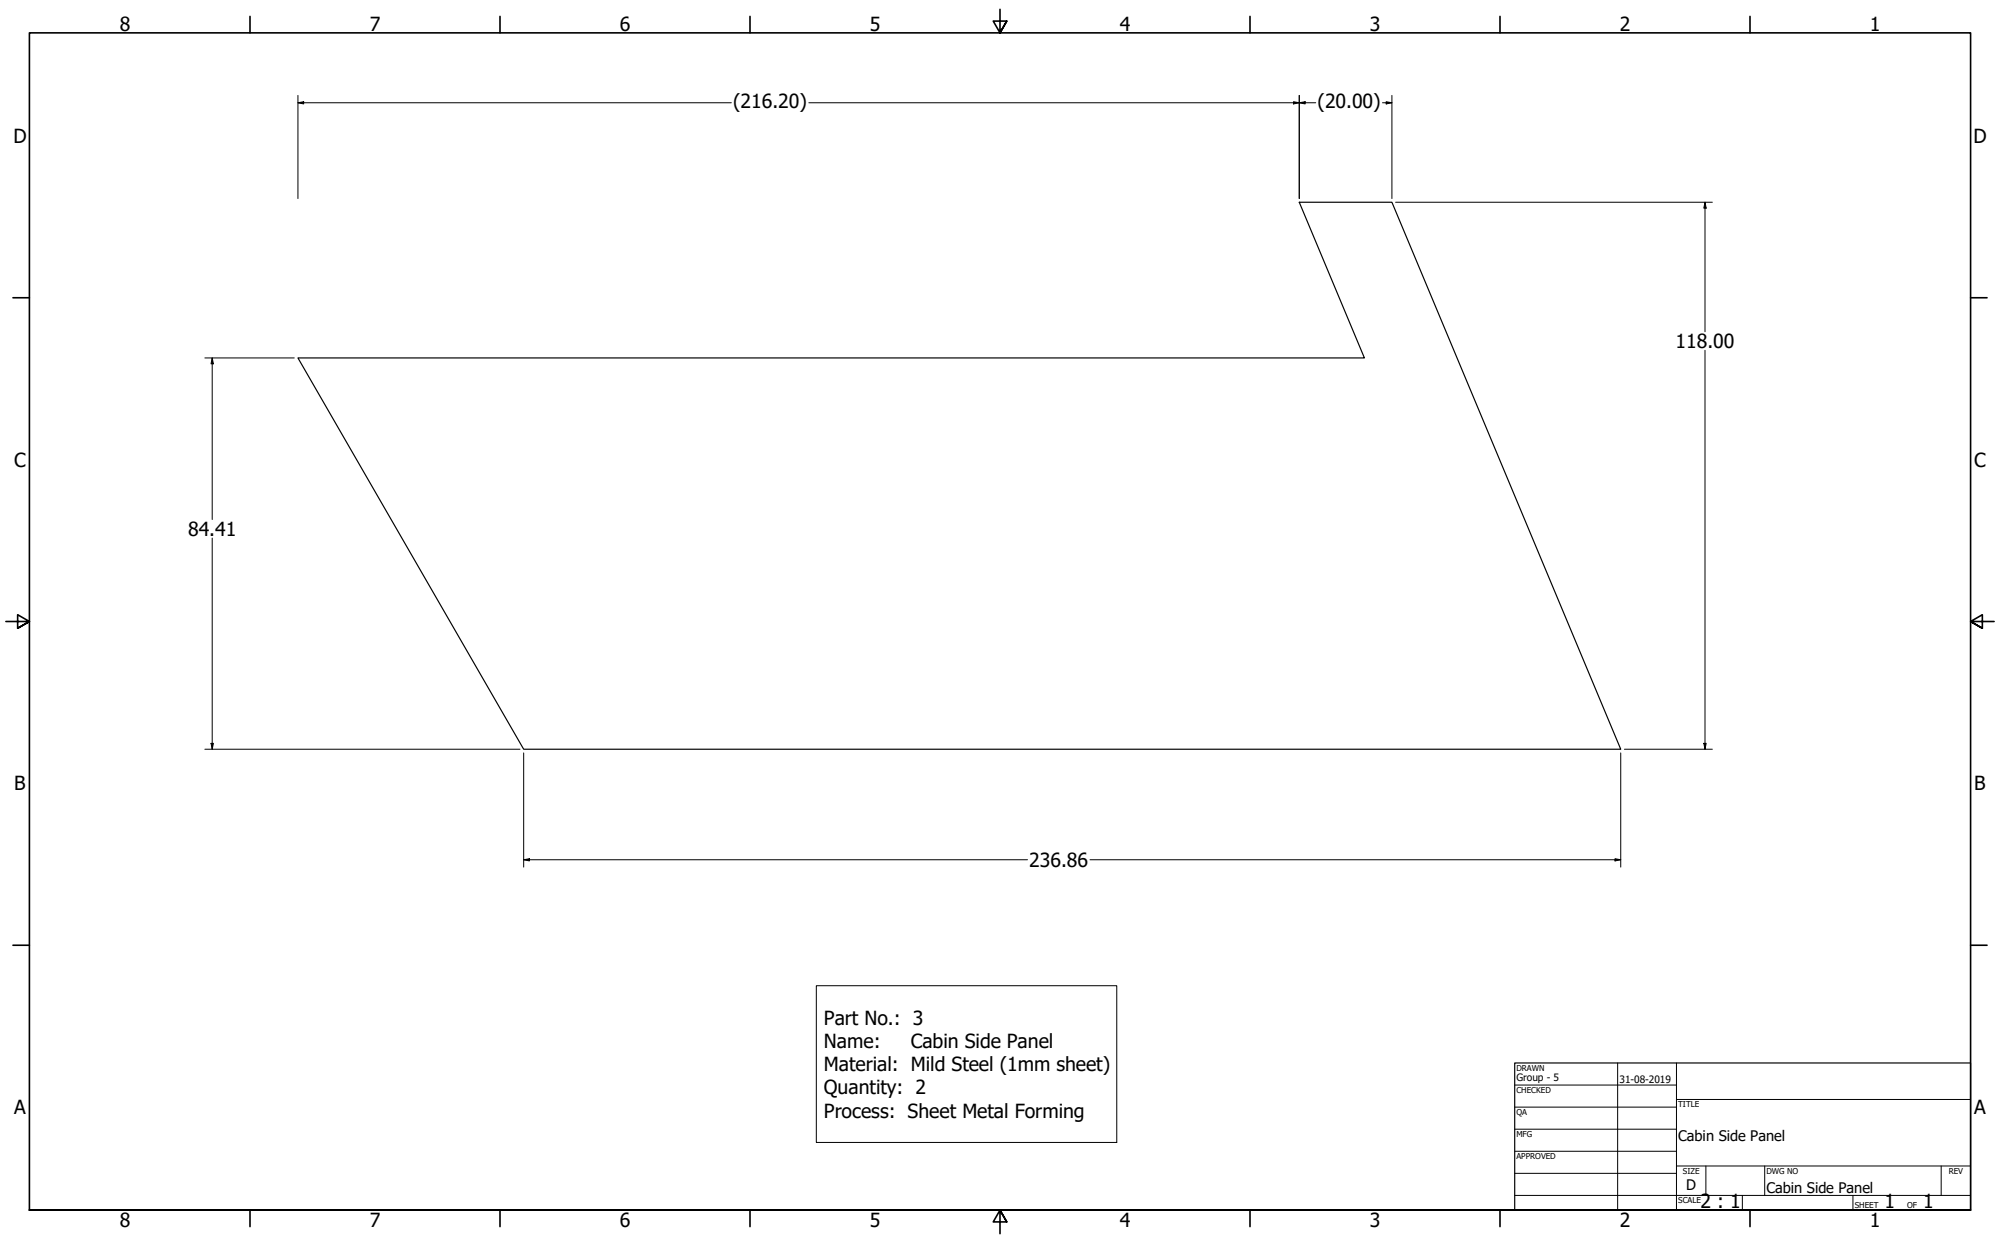
[picture p24: page 1]
Name:; Cabin Side Panel

Part No.: 3
Material: Mild Steel (1mm sheet)
Quantity: 2
Process: Sheet Metal Forming

DRAWN Group - 5 | 31-08-2019

CHECKED

MFG

Cabin Side Panel

APPROVED

SIZE D | DWG NO Cabin Side Panel | REV

2 : 1 SCALE | | SHEET 1 OF 1
