AdvancingMind/Spyder-Crab/Drawings/Pdf/Autocad Pdf/Crank Joint Pin Spider Crab.pdf

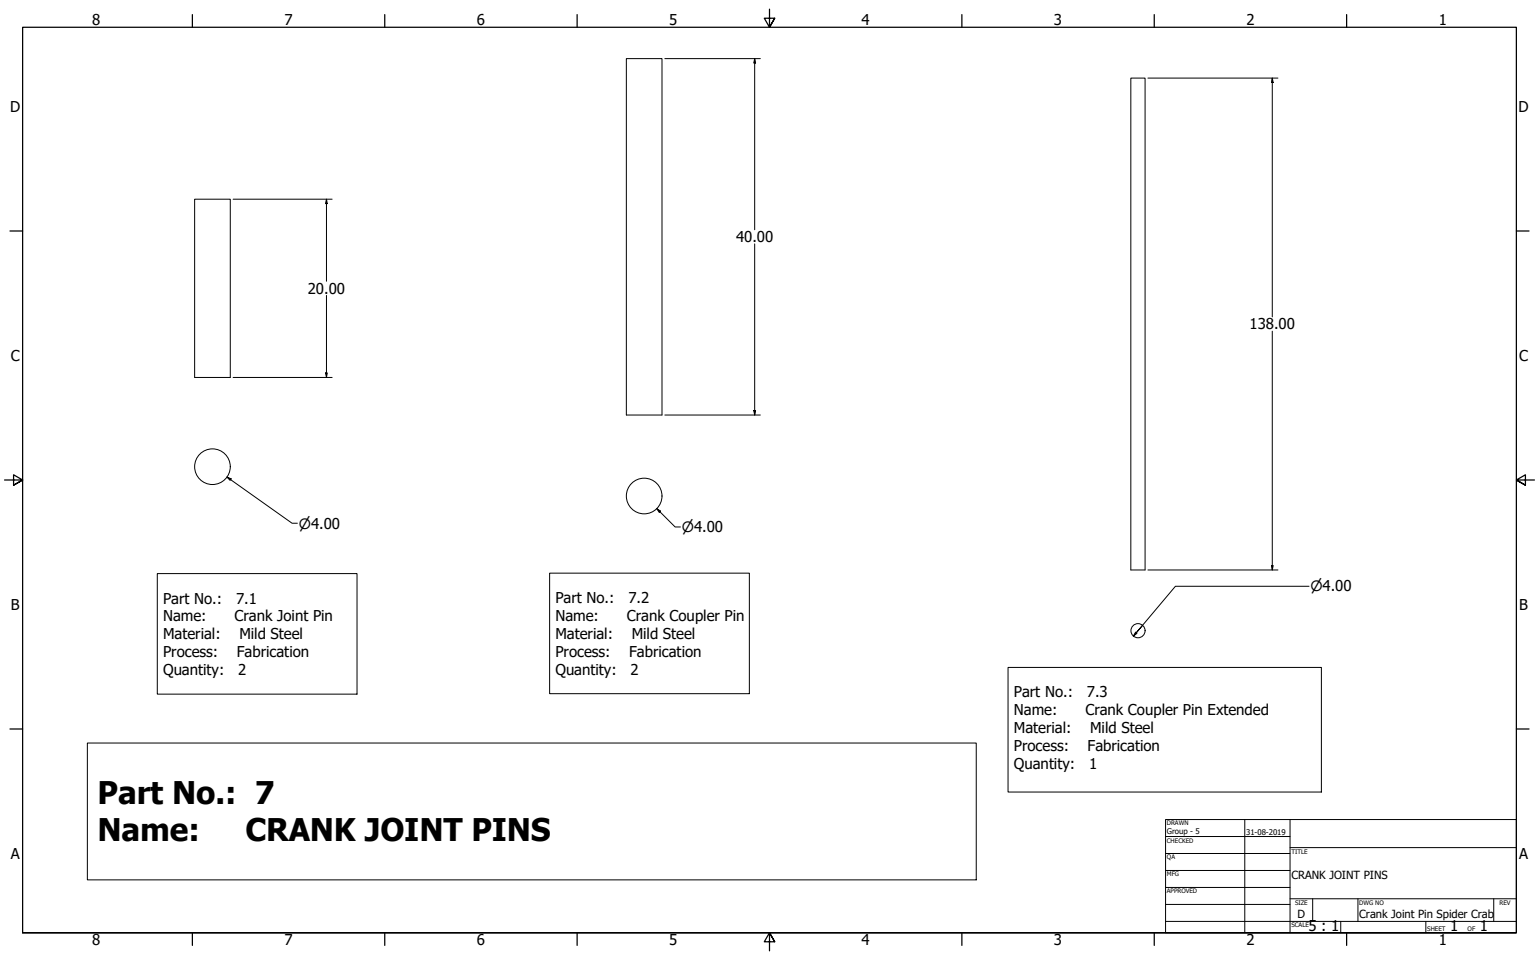
[picture p25: page 1]
Part No.: 7.1; Name:; Crank Joint Pin; Material:; Mild Steel; Quantity: 2; Part No.: 7.2; Crank Coupler Pin; Part No.: 7.3; Crank Coupler Pin Extended; Quantity: 1; Part No.: 7; CRANK JOINT PINS

DRAWN Group - 5 | 31-08-2019

CHECKED

MFG

CRANK JOINT PINS

APPROVED

SIZE D | DWG NO Crank Joint Pin Spider Crab | REV

5 : 1 SCALE | | SHEET 1 OF 1
