AdvancingMind/Spyder-Crab/Drawings/Pdf/Autocad Pdf/Crank.pdf

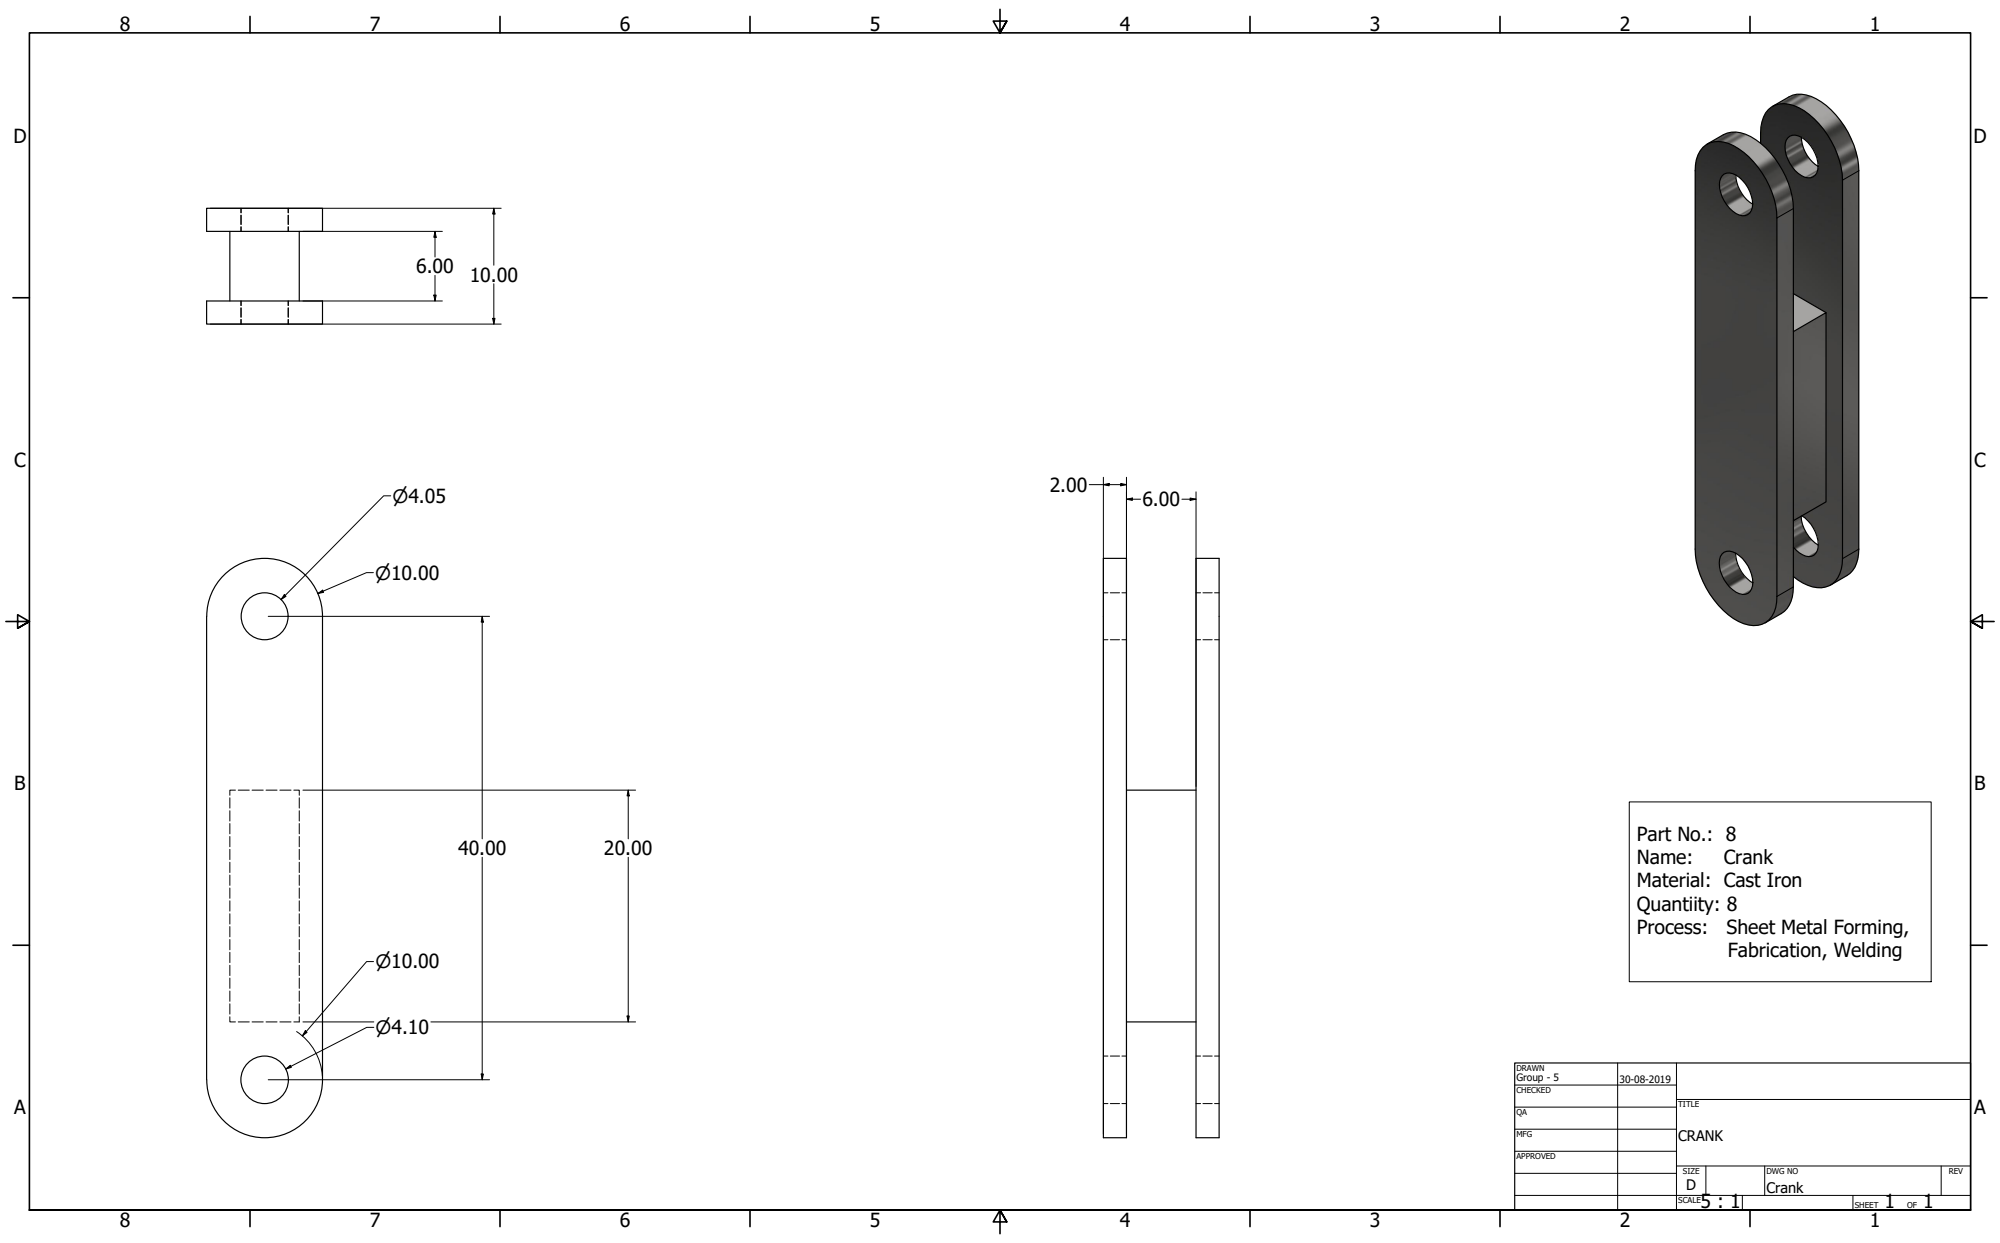
[picture p26: page 1]
Fabrication, Welding

Part No.: 8
Material: Cast Iron
Quantiity: 8
Process: Sheet Metal Forming,

DRAWN Group - 5 | 30-08-2019

CHECKED

MFG

APPROVED

SIZE D | DWG NO Crank | REV

5 : 1 SCALE | | SHEET 1 OF 1
