AdvancingMind/Spyder-Crab/Drawings/Pdf/Autocad Pdf/Flywheel.pdf

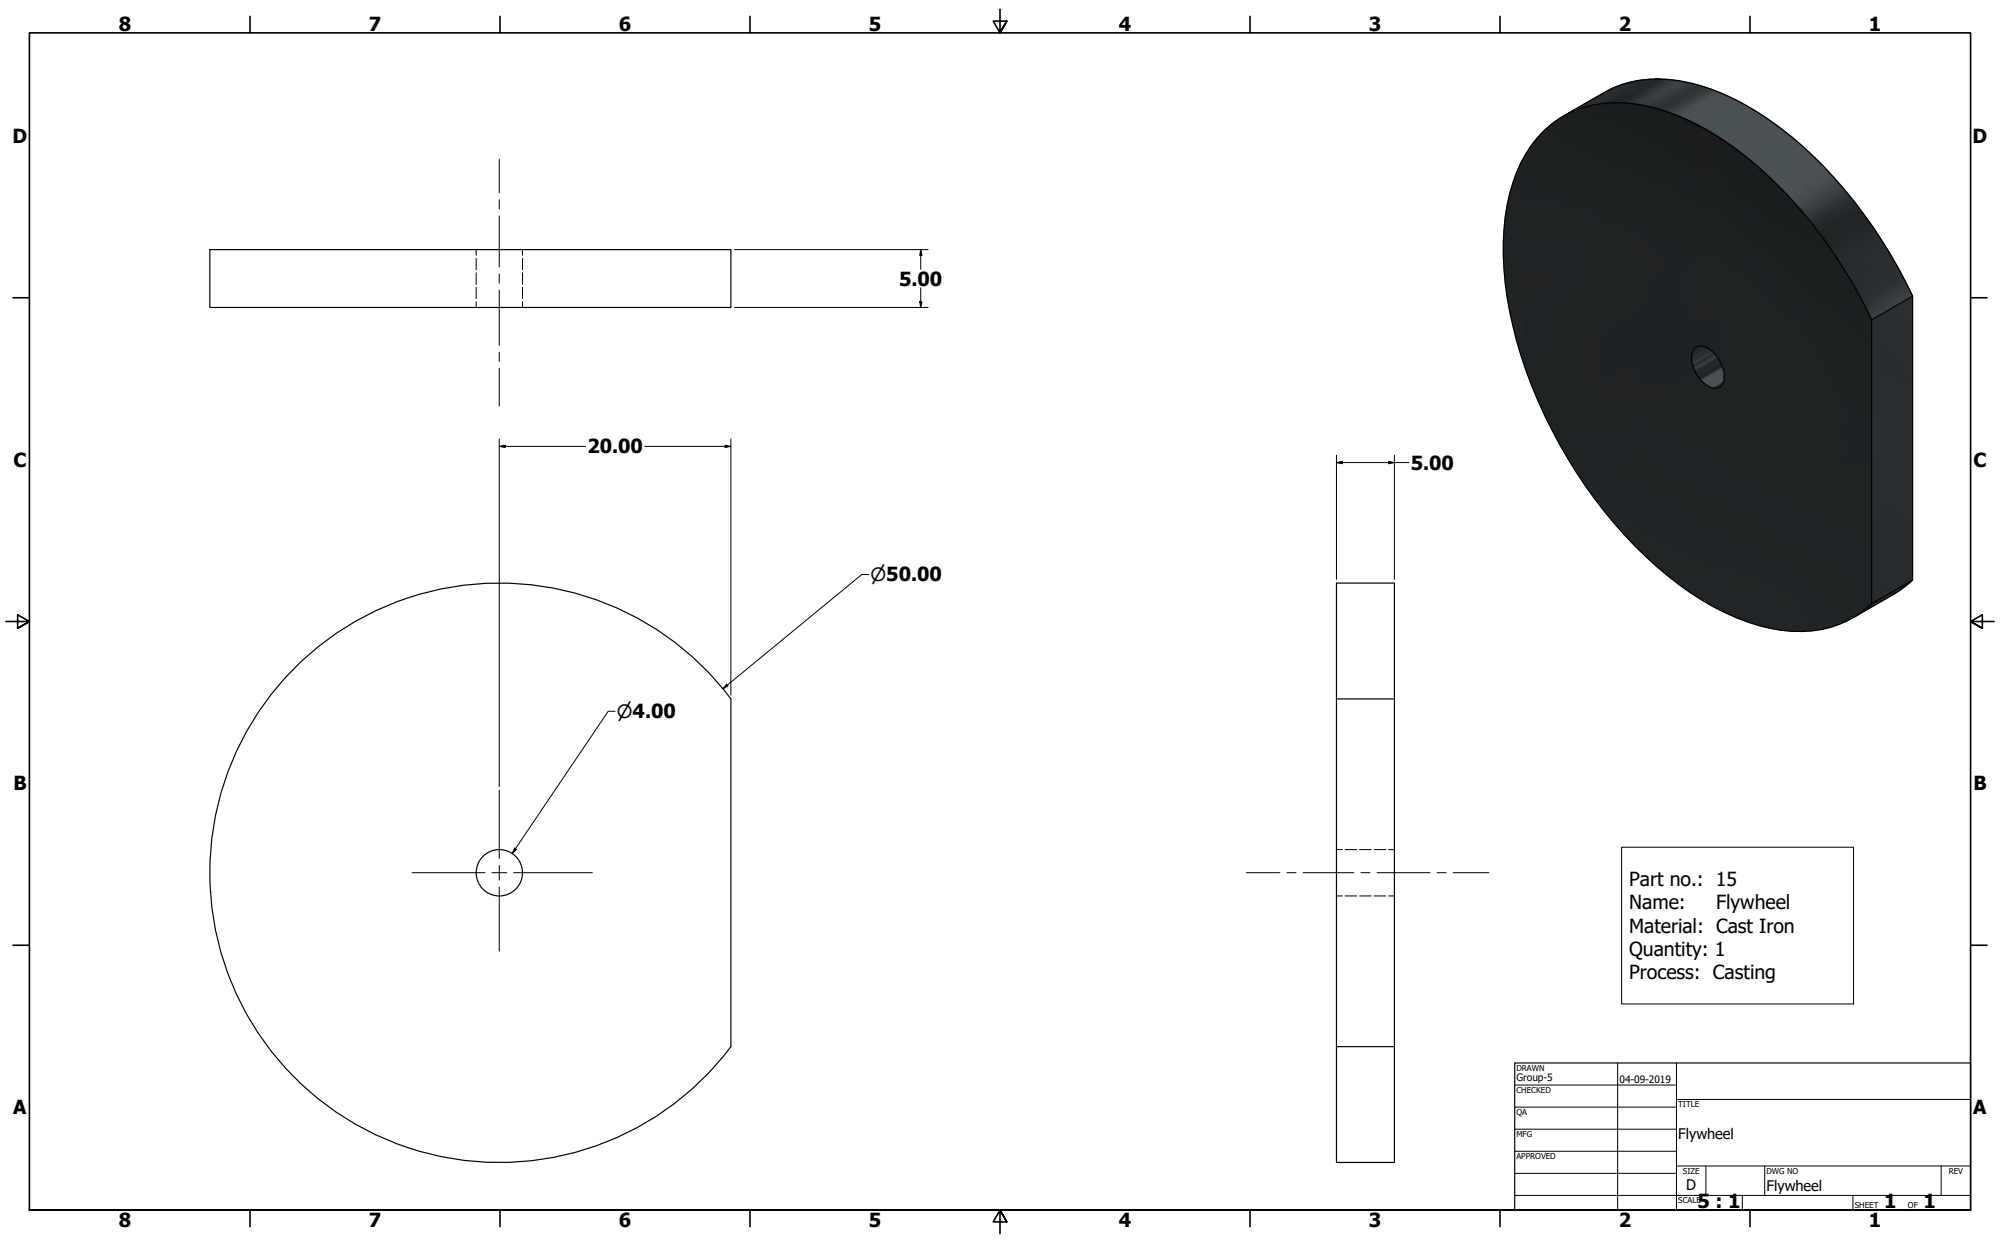
[picture p27: page 1]

Part no.: 15
Material: Cast Iron
Quantity: 1
Process: Casting

DRAWN Group-5 | 04-09-2019

CHECKED

MFG

APPROVED

SIZE D | DWG NO Flywheel | REV

5 : 1 SCALE | | SHEET 1 OF 1
