AdvancingMind/Spyder-Crab/Drawings/Pdf/Autocad Pdf/Frame.pdf

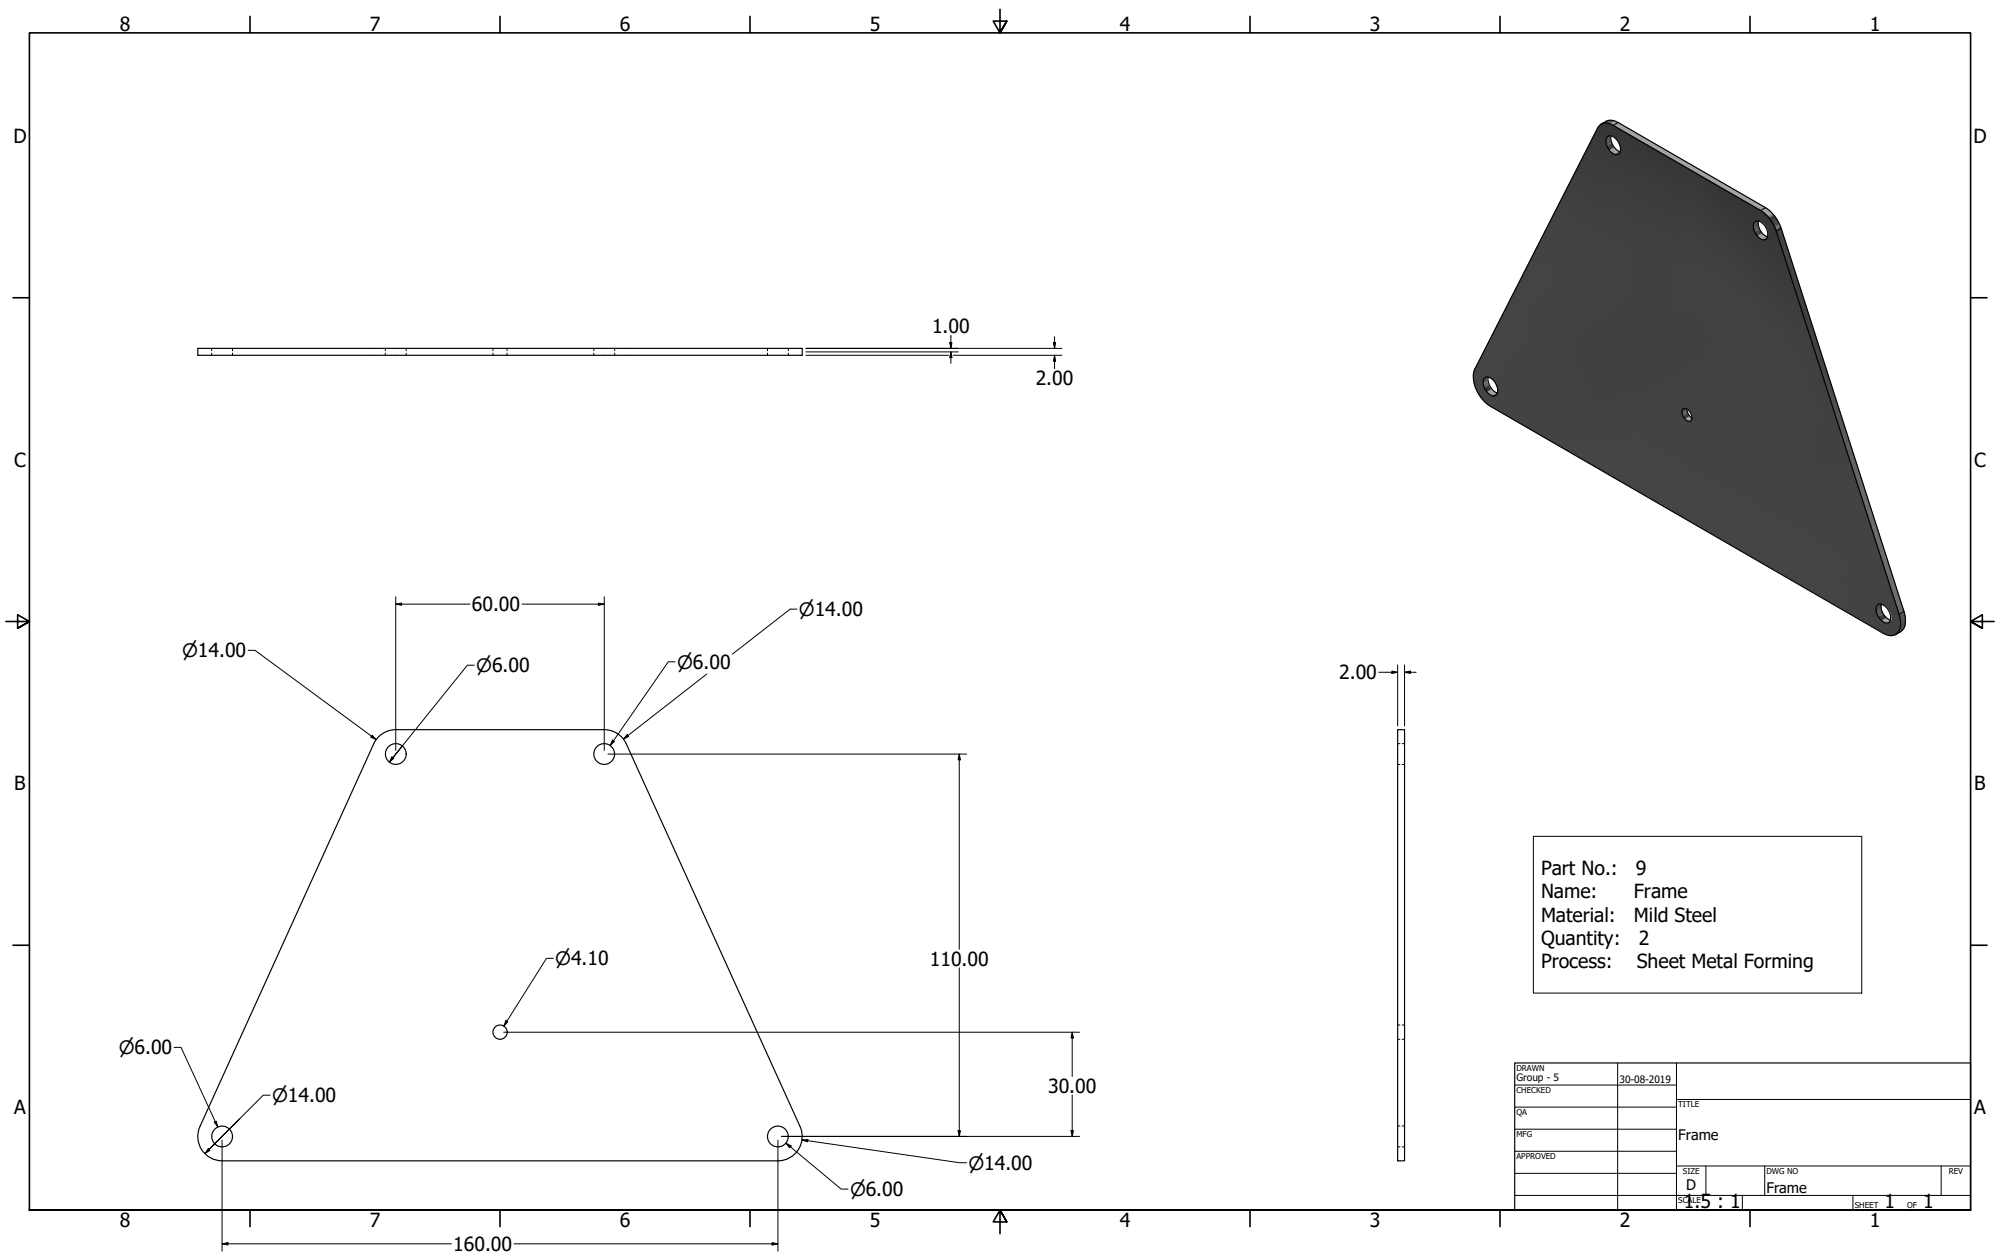
[picture p28: page 1]
Process:; Sheet Metal Forming

Part No.: 9
Material: Mild Steel
Quantity: 2

DRAWN Group - 5 | 30-08-2019

CHECKED

MFG

APPROVED

SIZE D | DWG NO Frame | REV

1.5 : 1 SCALE | | SHEET 1 OF 1
