AdvancingMind/Spyder-Crab/Drawings/Pdf/Autocad Pdf/Leg Joint Pins.pdf

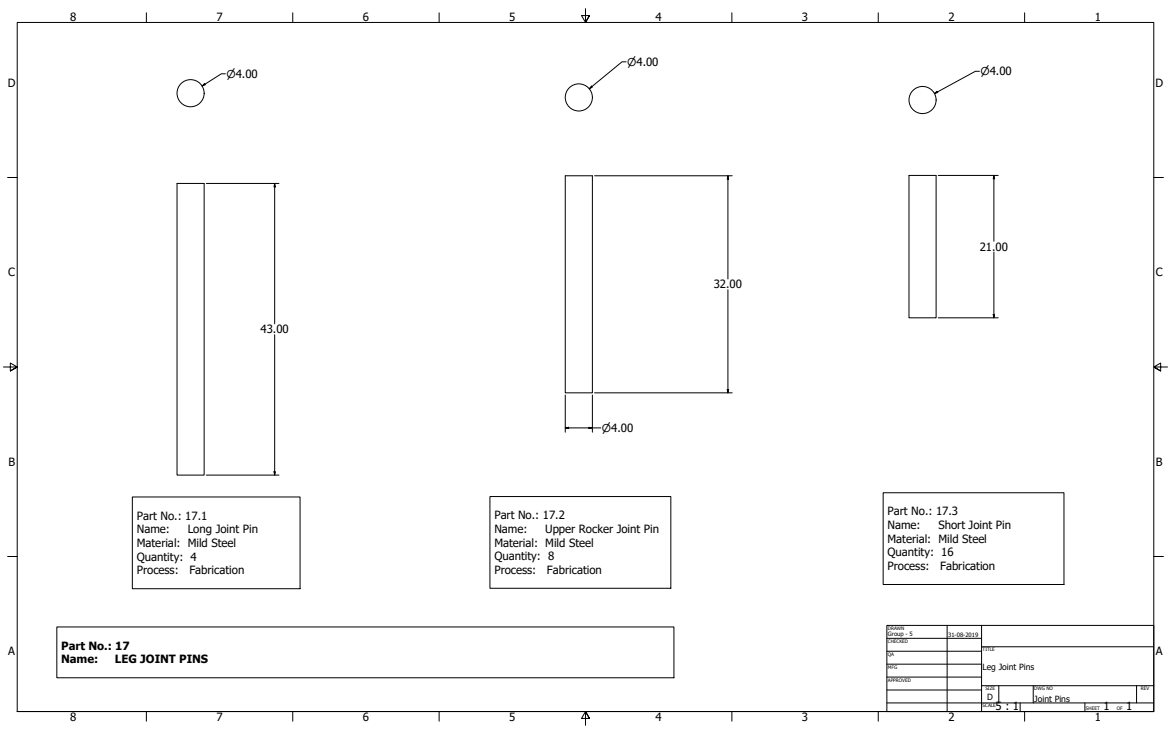
[picture p29: page 1]
Name:; Long Joint Pin; Upper Rocker Joint Pin; Short Joint Pin; Part No.: 17; LEG JOINT PINS

Part No.: 17.3
Material: Mild Steel
Quantity: 16
Process: Fabrication

Part No.: 17.1
Quantity: 4

Part No.: 17.2
Quantity: 8

DRAWN Group - 5 | 31-08-2019

CHECKED

TITLE
Leg Joint Pins

MFG

APPROVED

SIZE D | DWG NO Joint Pins | REV

5 : 1 SCALE | | SHEET 1 OF 1
