AdvancingMind/Spyder-Crab/Drawings/Pdf/Autocad Pdf/Leg Spider Crab.pdf

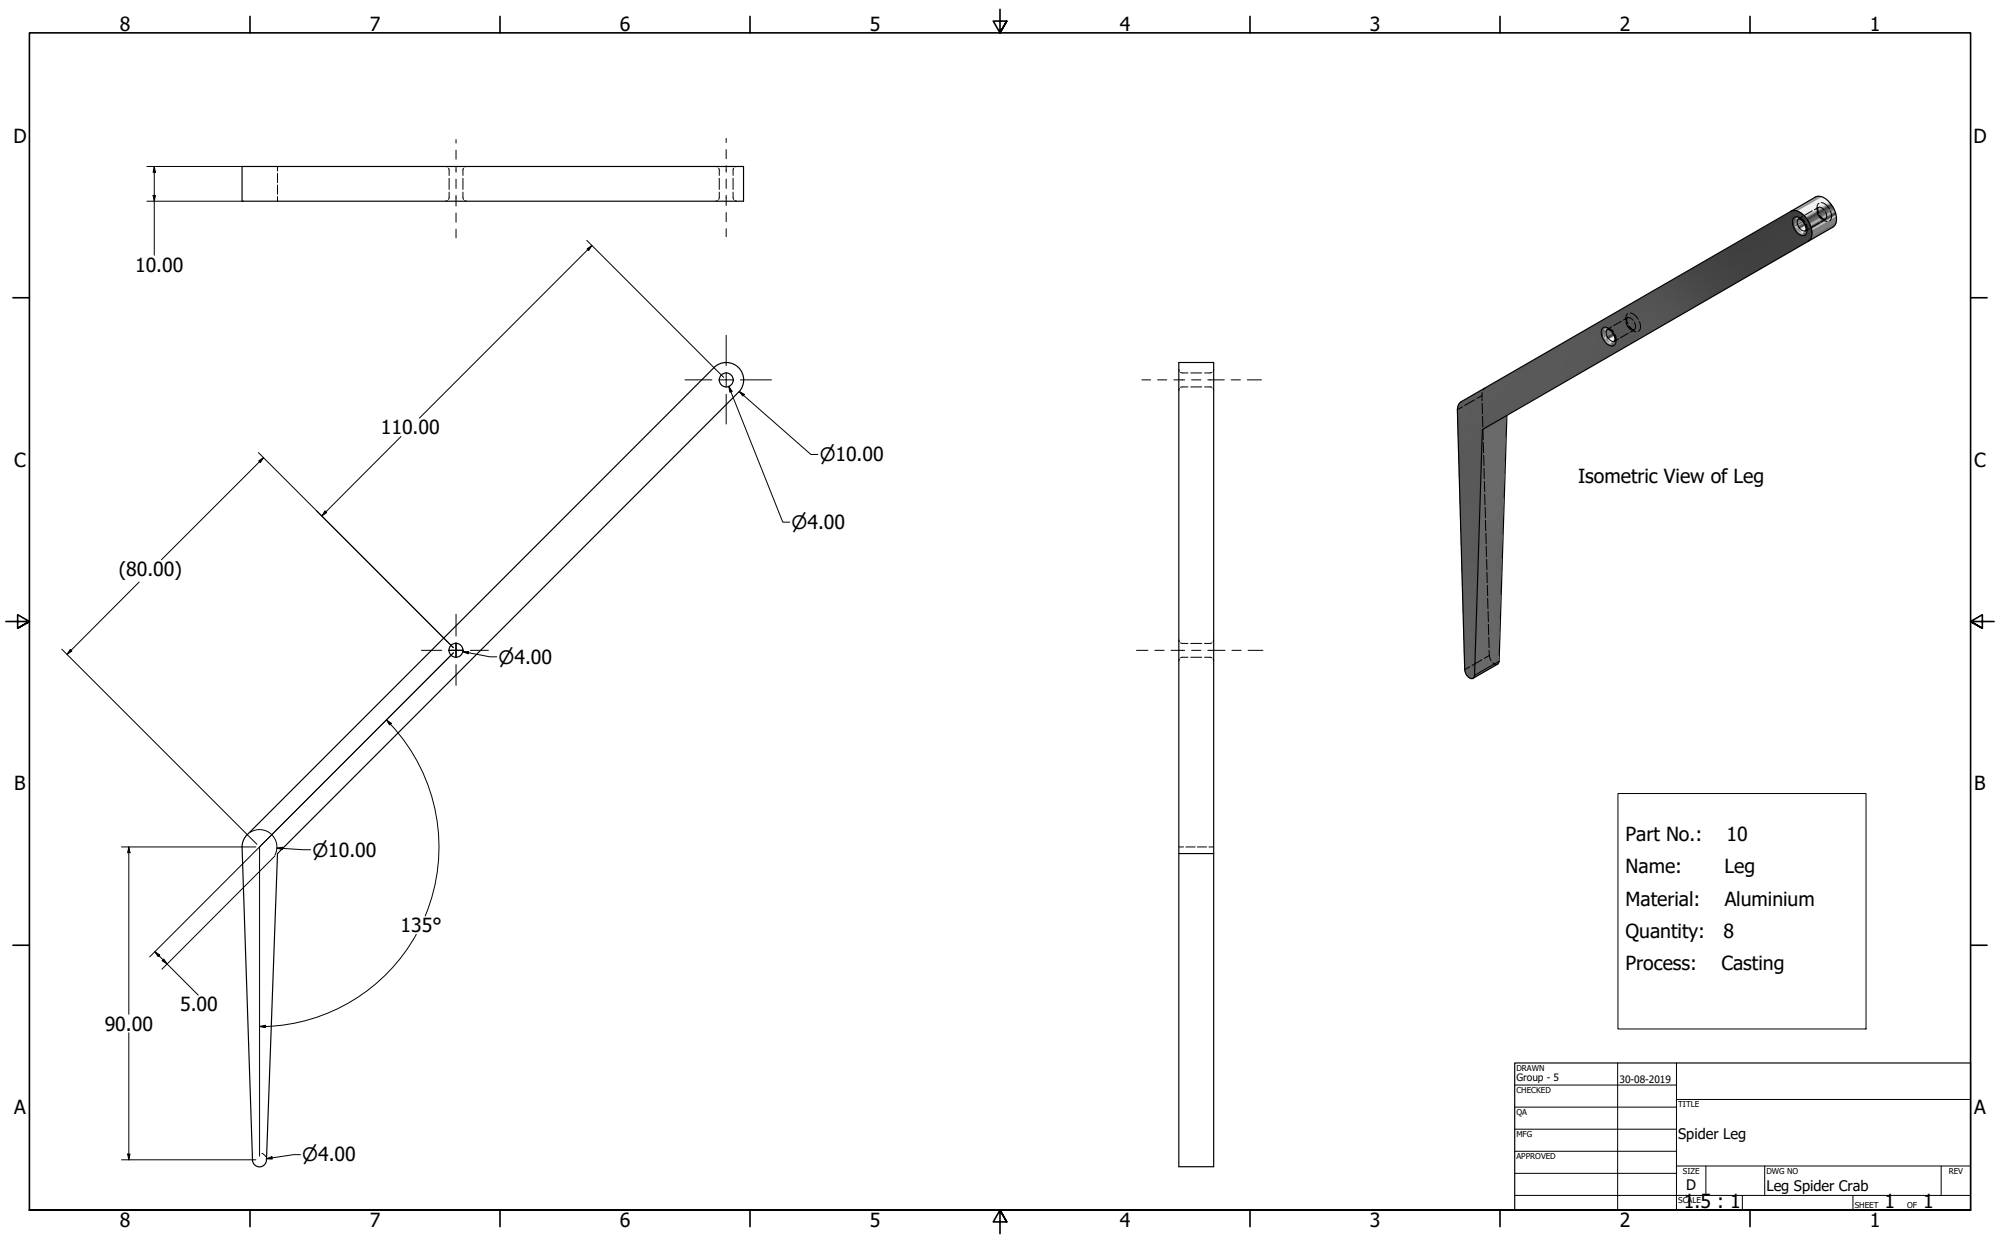
[picture p30: page 1]
Spider Leg; Part No.:; Quantity: 8

Isometric View of Leg

DRAWN Group - 5 | 30-08-2019

CHECKED

MFG

APPROVED

SIZE D | DWG NO Leg Spider Crab | REV

1.5 : 1 SCALE | | SHEET 1 OF 1
