AdvancingMind/Spyder-Crab/Drawings/Pdf/Autocad Pdf/Lower Rocker Arm Spider Crab.pdf

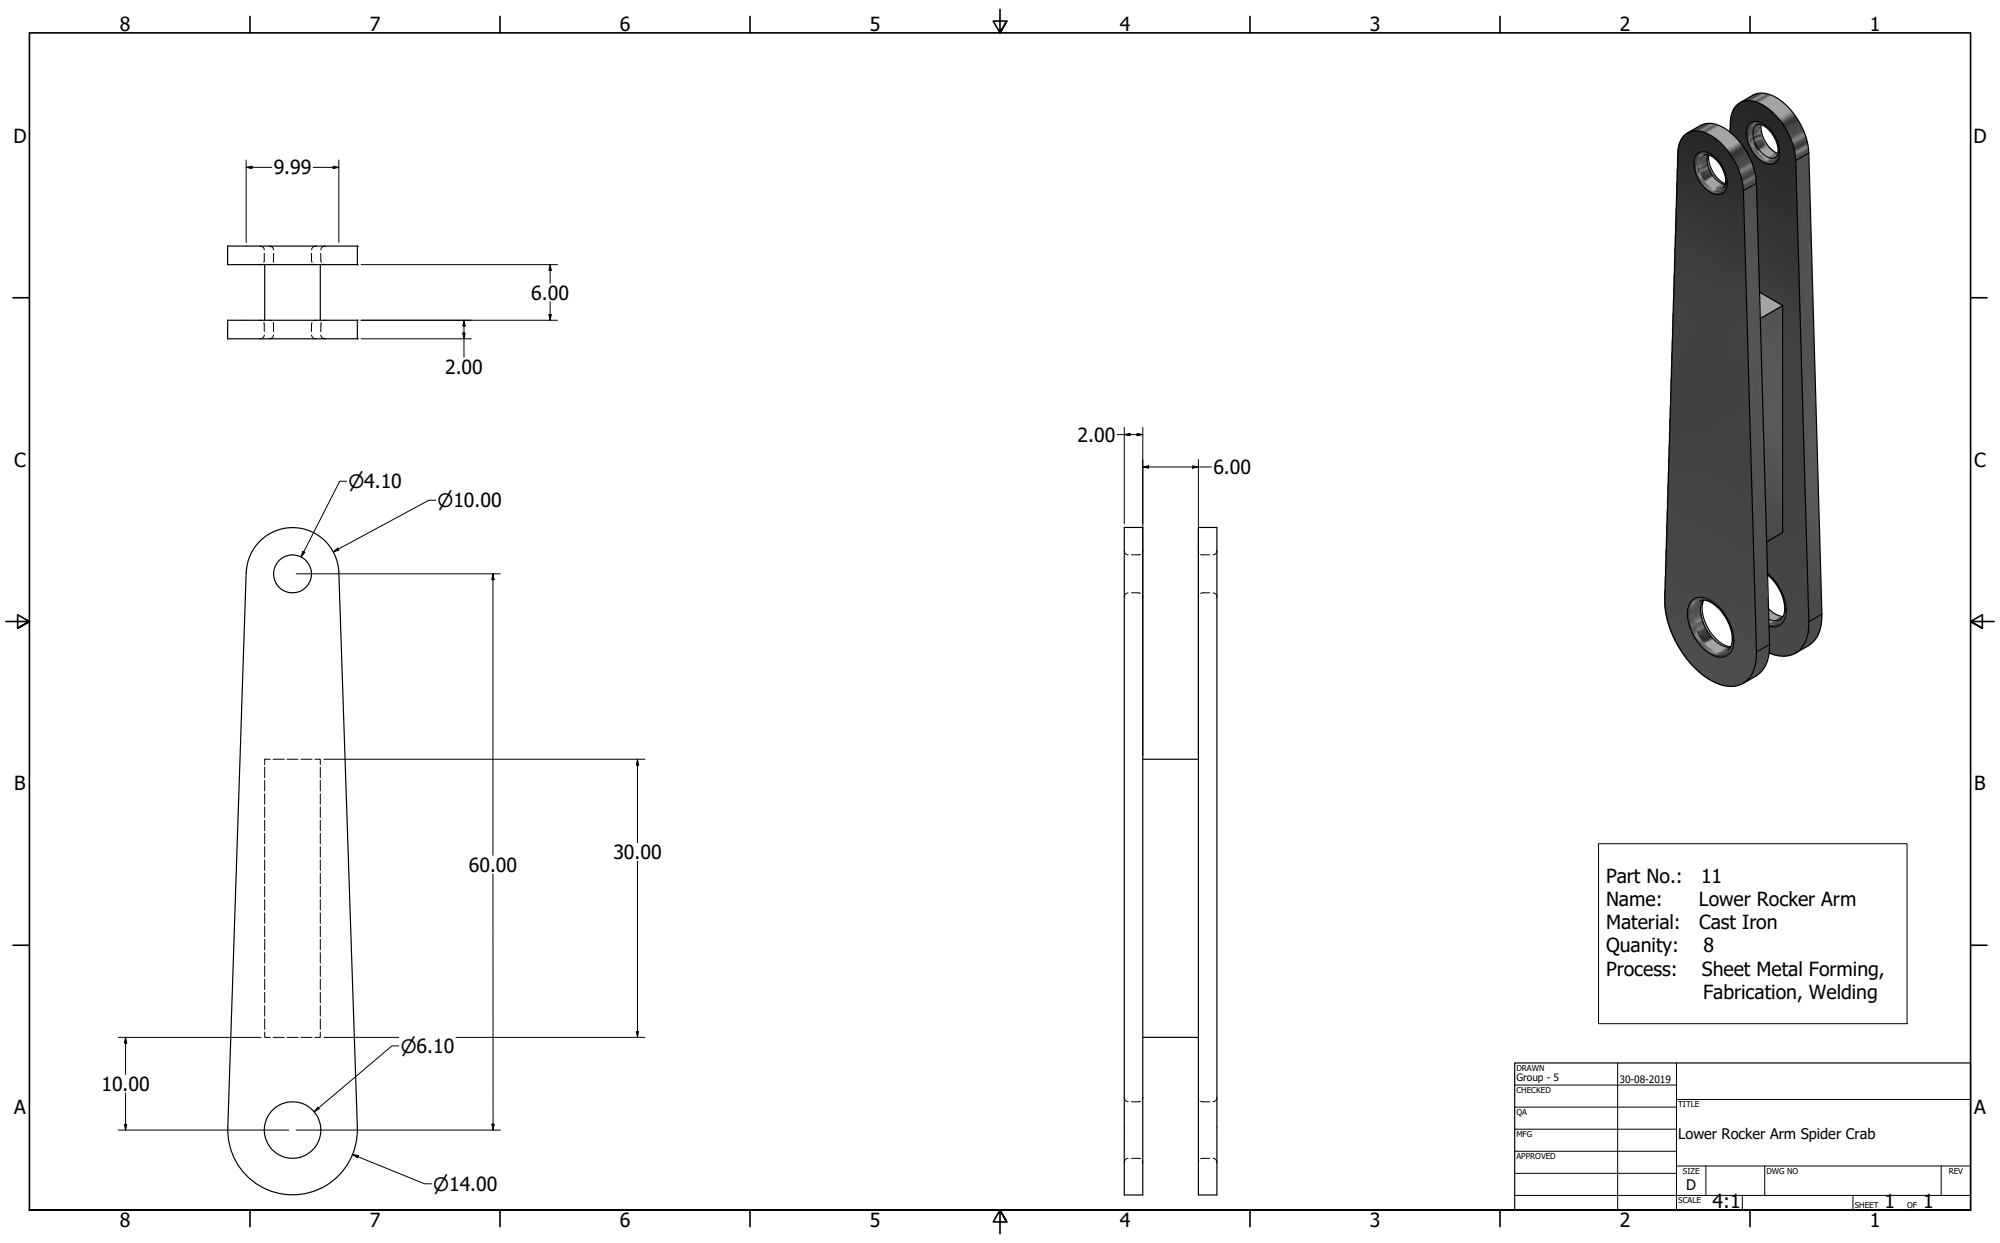
[picture p31: page 1]
Name:; Lower Rocker Arm; Process:; Sheet Metal Forming,; Fabrication, Welding

Part No.: 11
Material: Cast Iron

DRAWN Group - 5 | 30-08-2019

CHECKED

Lower Rocker Arm Spider Crab

MFG

APPROVED

SIZE D | DWG NO | REV

4:1 SCALE | | SHEET 1 OF 1
