AdvancingMind/Spyder-Crab/Drawings/Pdf/Autocad Pdf/Rocker arm.pdf

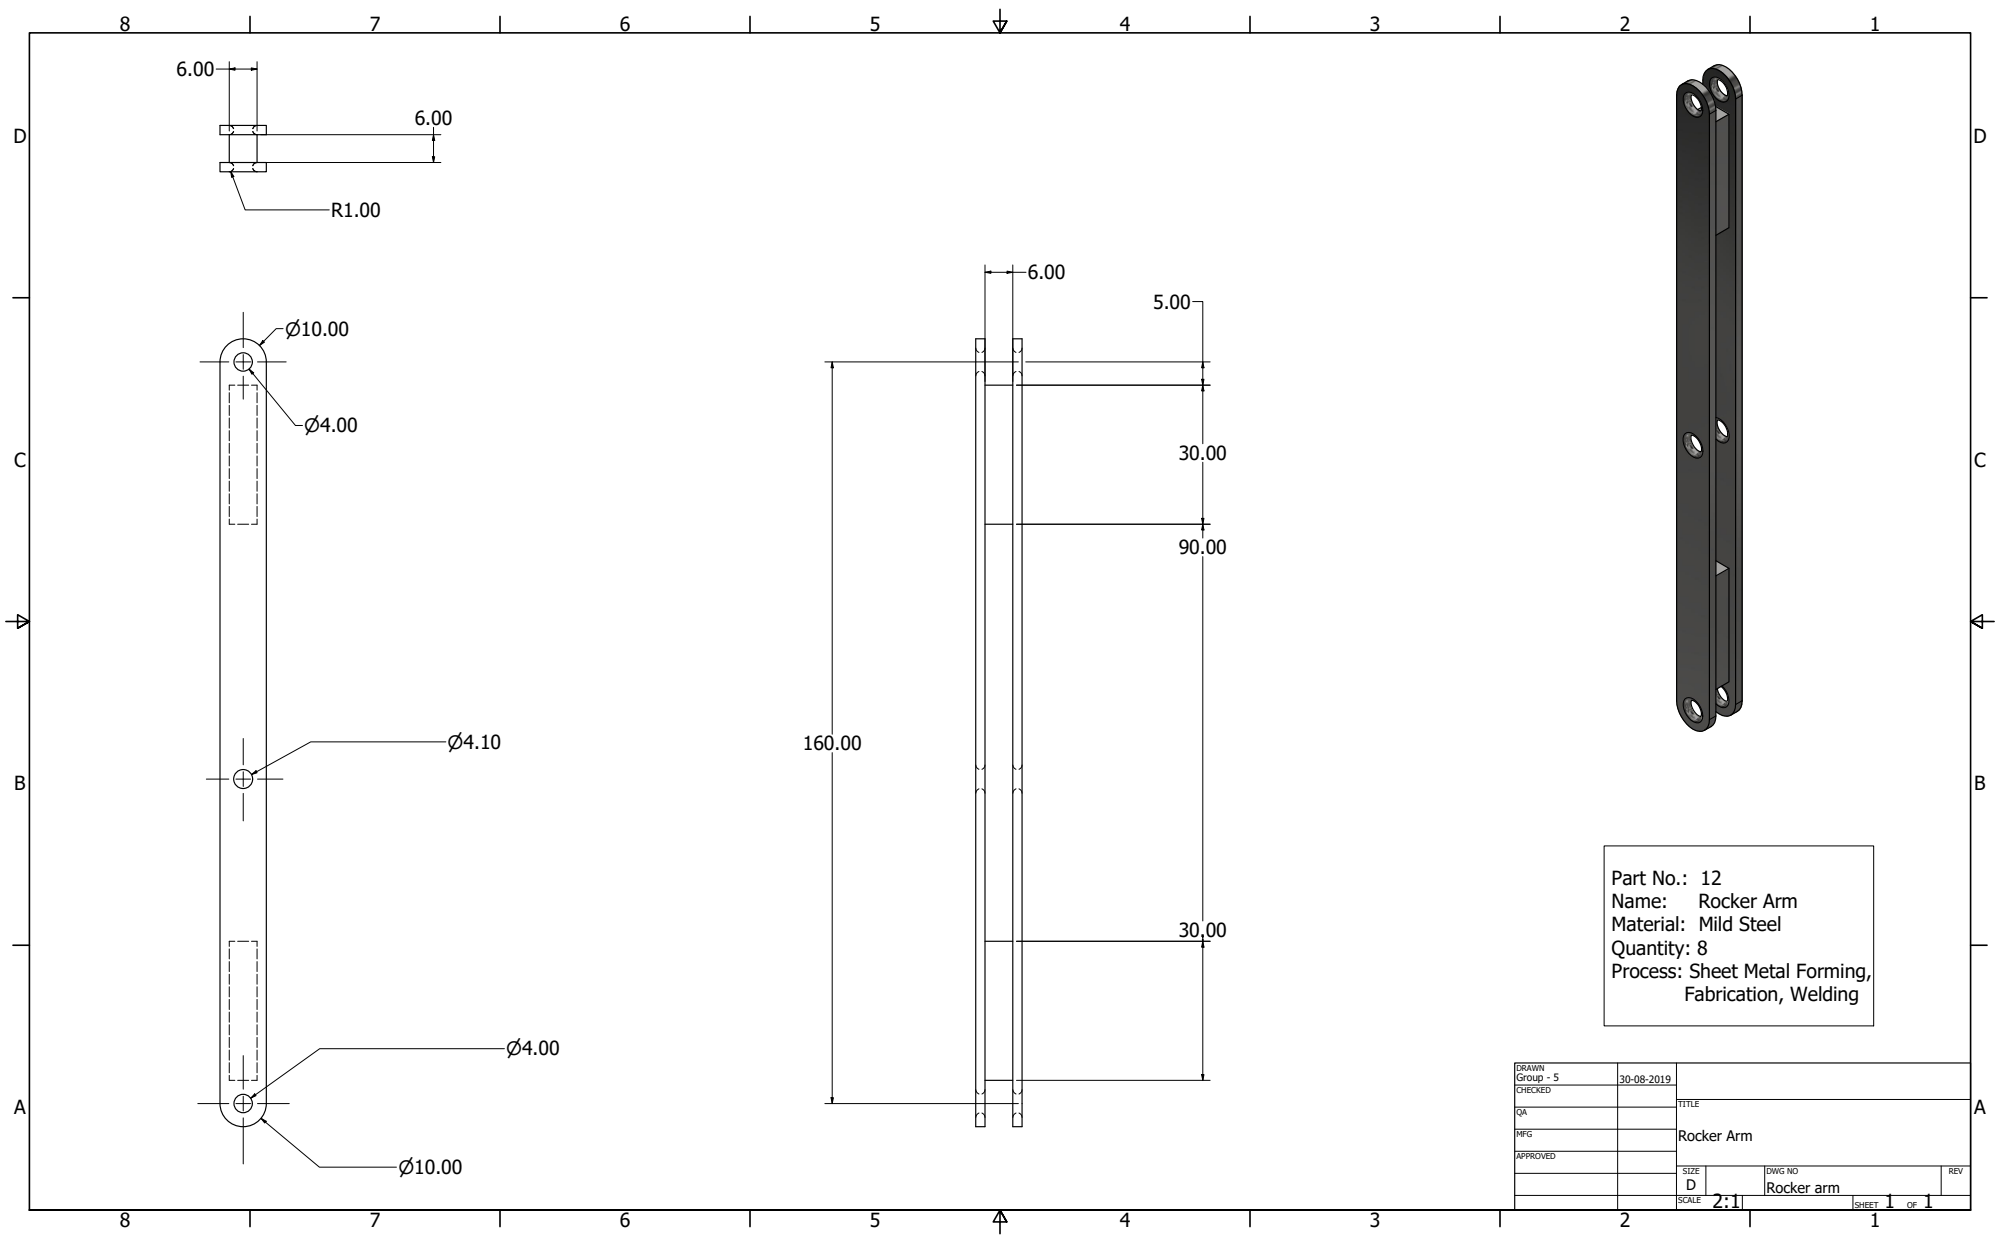
[picture p32: page 1]
Rocker Arm; Name:; Fabrication, Welding

Part No.: 12
Material: Mild Steel
Quantity: 8
Process: Sheet Metal Forming,

DRAWN Group - 5 | 30-08-2019

CHECKED

MFG

APPROVED

SIZE D | DWG NO Rocker arm | REV

2:1 SCALE | | SHEET 1 OF 1
