AdvancingMind/Spyder-Crab/Drawings/Pdf/Autocad Pdf/Rods.pdf

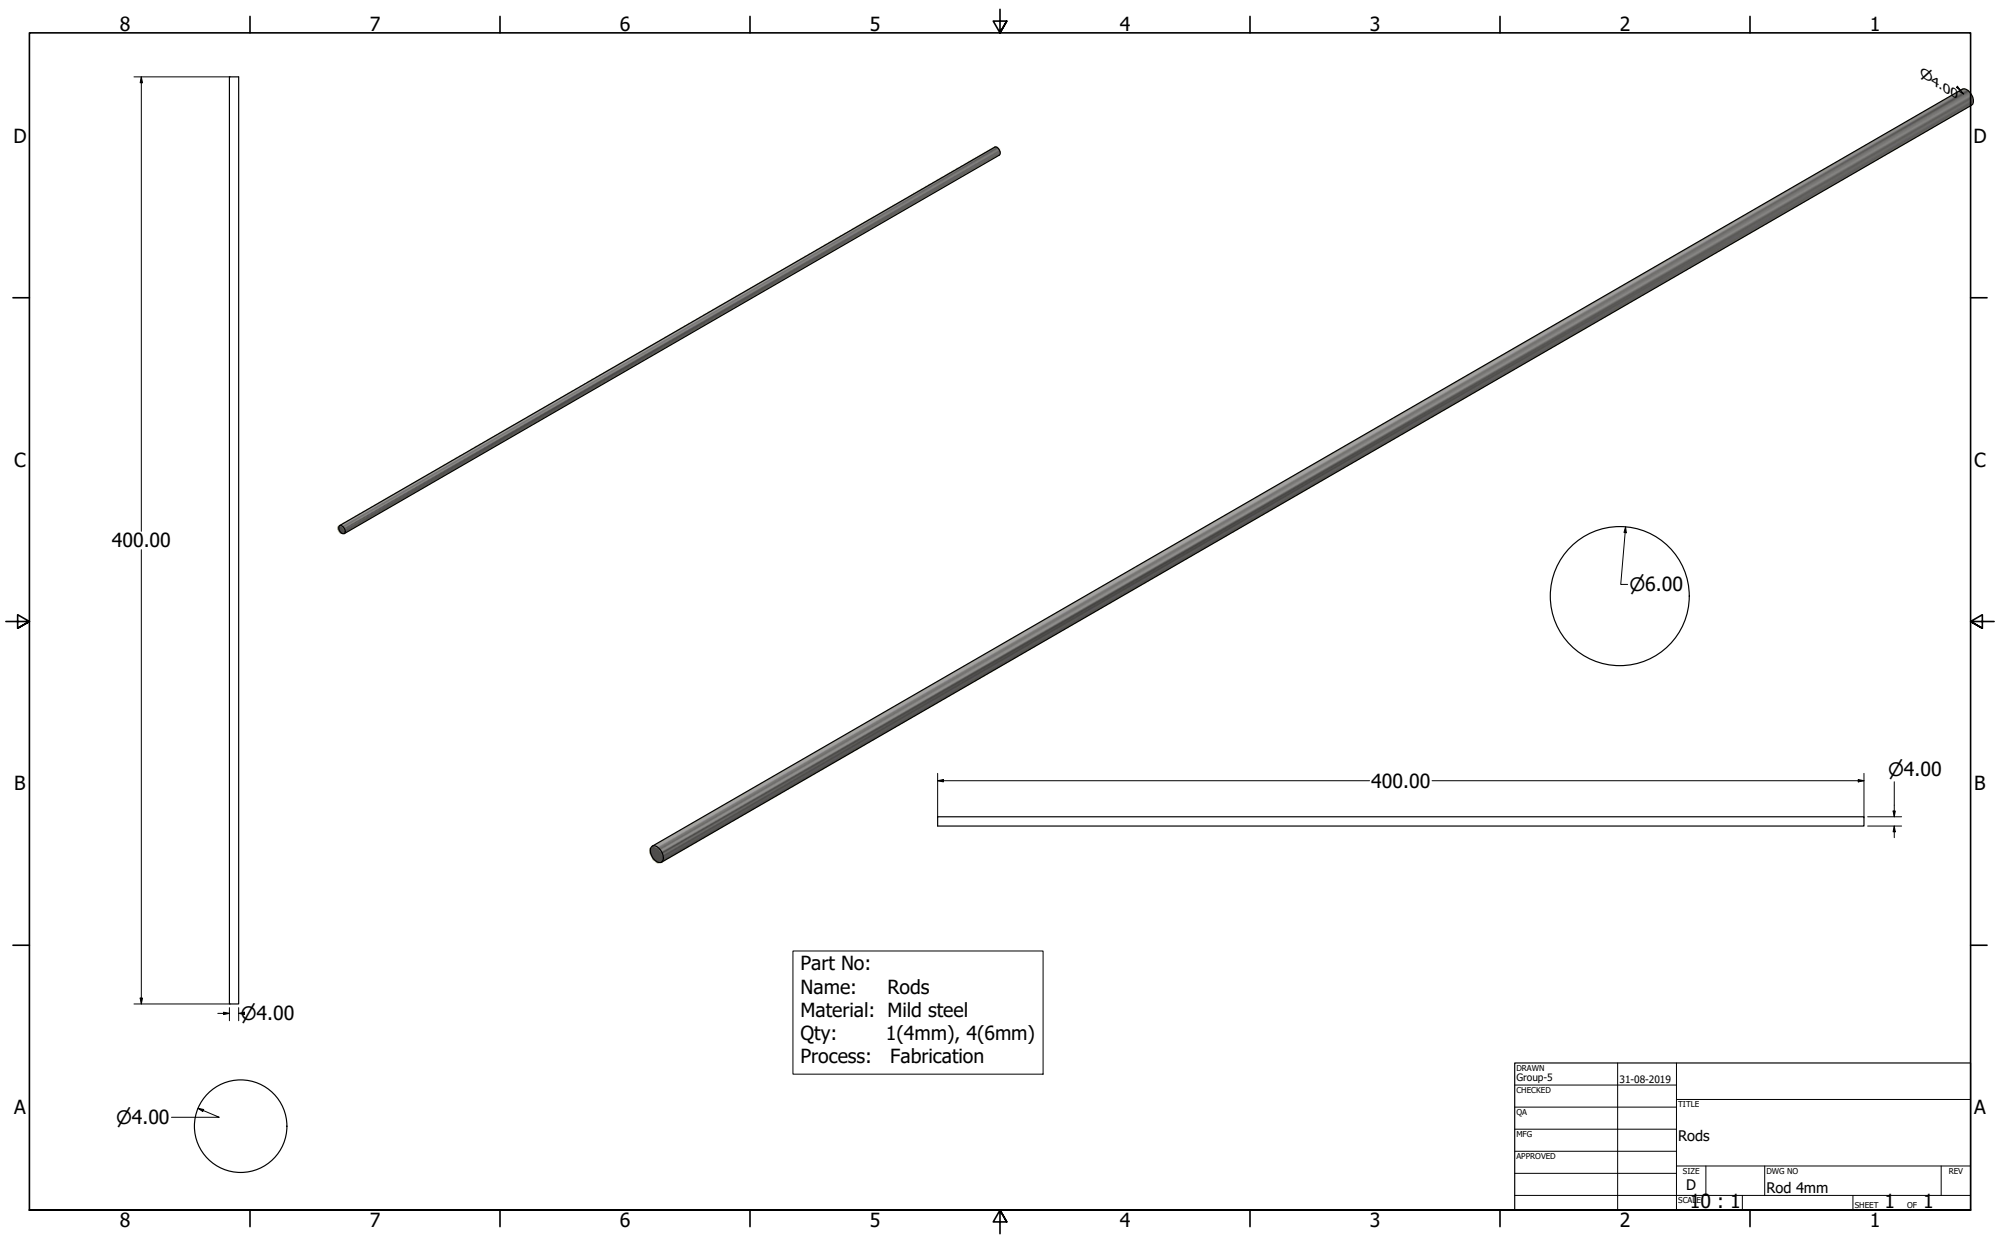
[picture p33: page 1]
Qty:

Part No:
Material: Mild steel
Process: Fabrication

DRAWN Group-5 | 31-08-2019

CHECKED

MFG

APPROVED

SIZE D | DWG NO Rod 4mm | REV

10 : 1 SCALE | | SHEET 1 OF 1
