AdvancingMind/Spyder-Crab/Drawings/Pdf/Autocad Pdf/Upper Rocker Arm Spider Crab.pdf

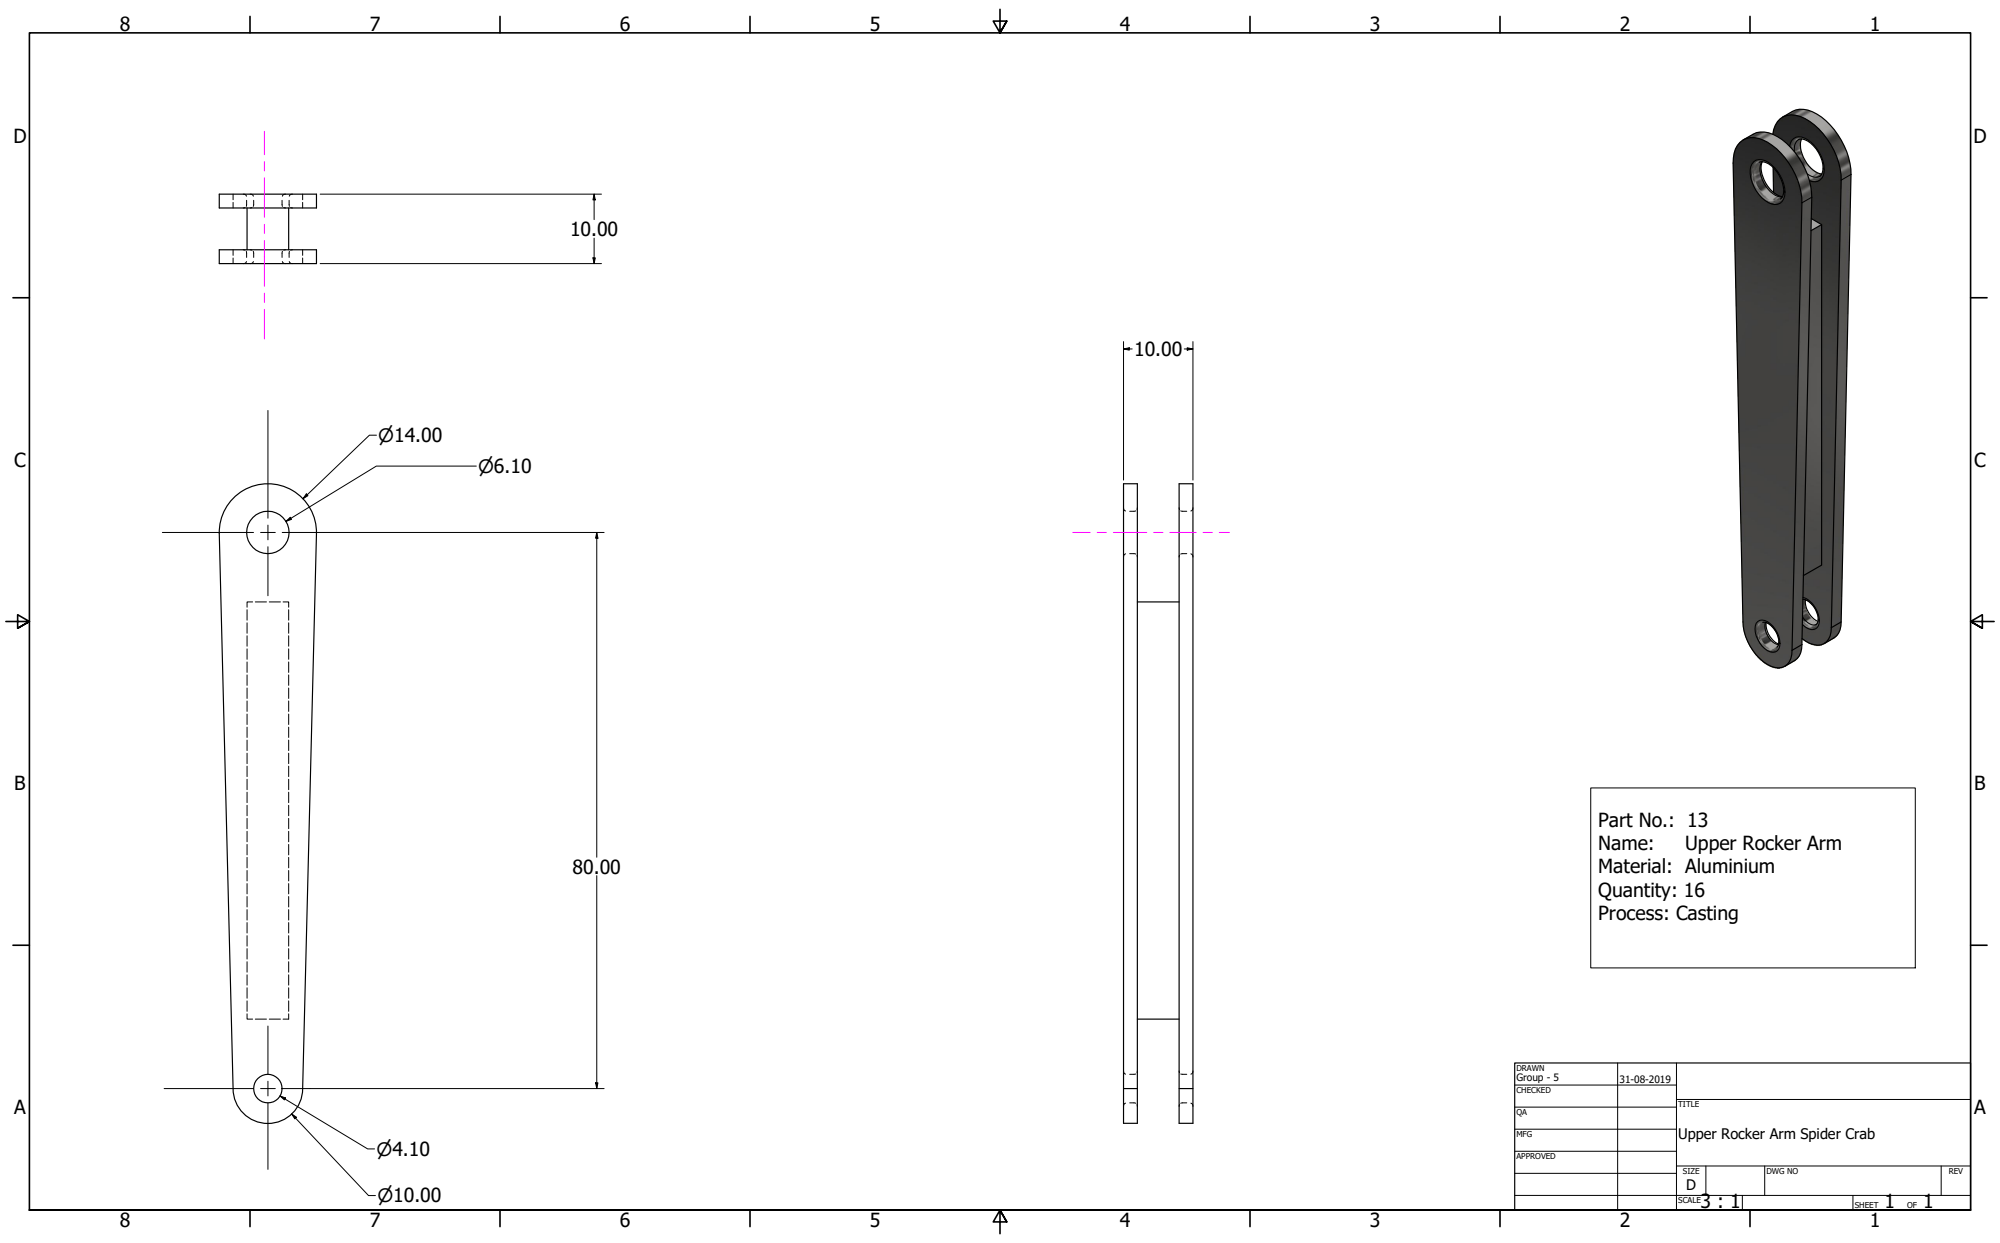
[picture p34: page 1]
Part No.: 13; Name:; Upper Rocker Arm; Material: Aluminium Quantity: 16 Process: Casting

DRAWN Group - 5 | 31-08-2019

CHECKED

Upper Rocker Arm Spider Crab

MFG

APPROVED

SIZE D | DWG NO | REV

3 : 1 SCALE | | SHEET 1 OF 1
