AdvancingMind/Spyder-Crab/Drawings/Pdf/Autocad Pdf/Leg Pair Assembly Spider Crab.pdf

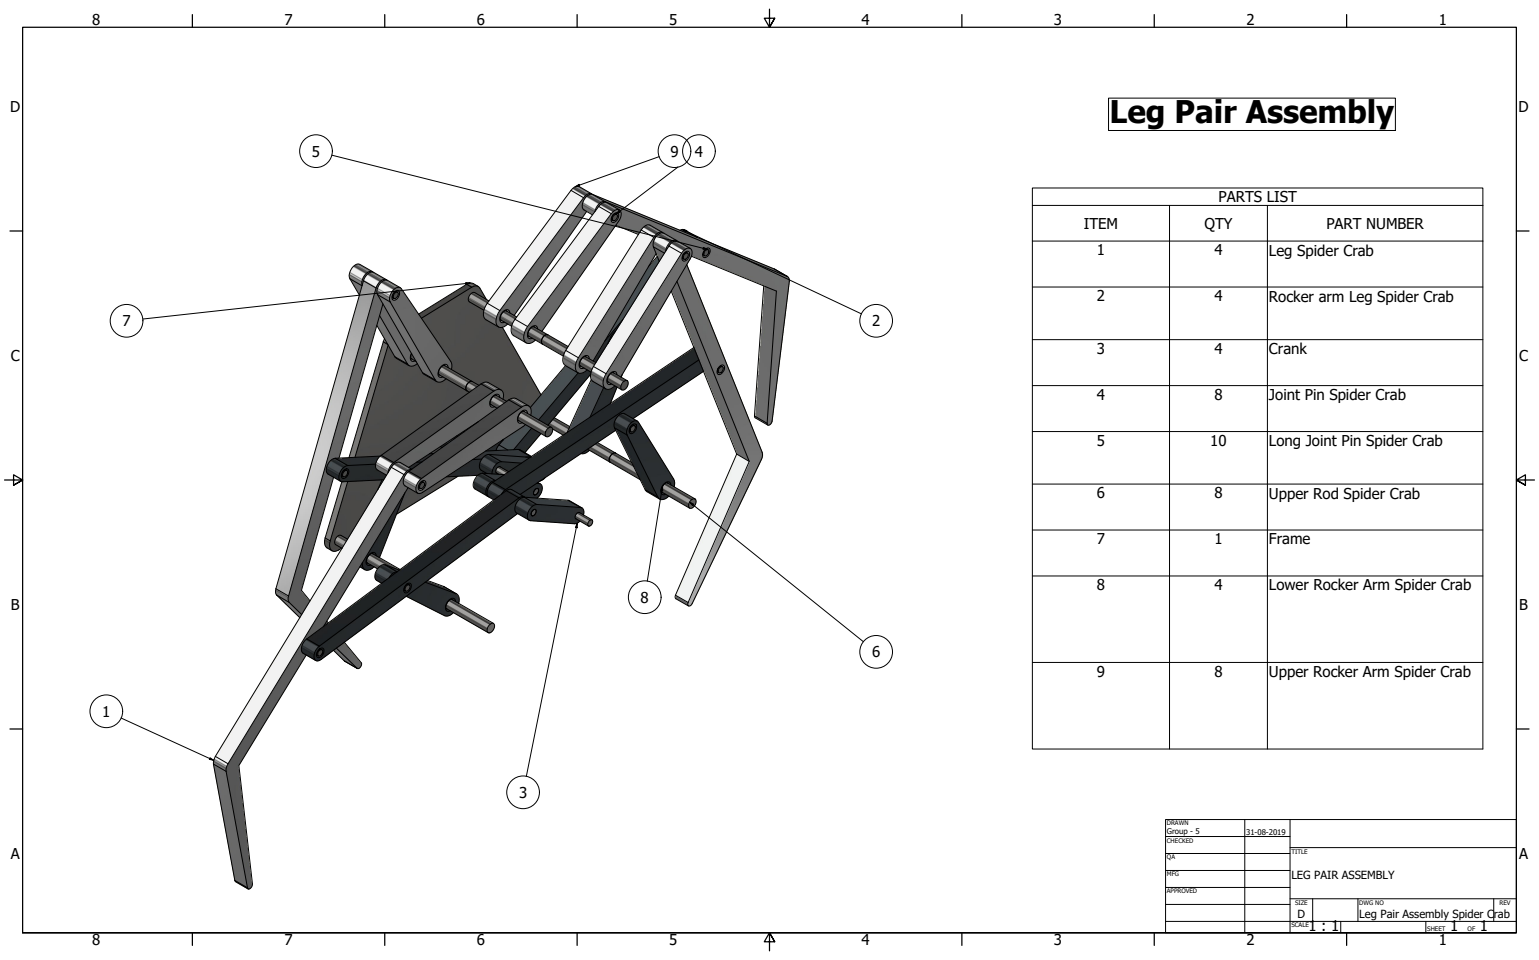
[picture p35: page 1]

I T E M | Q TY | P A RT N U M B E R
1 | 4 | L e g S p i d e r C r a b

S I Z E D | D W G N O L e g P a i r A s s e m bly S p i d e r C | R E V r a b
